BigFishC68/MineKey/docs/01-原理图审查.md

# 11 键 + EC11 旋钮键盘 —— 原理图审查报告

| 项目 | 内容 |
|---|---|
| 审查对象 | `keyboard.eprj2`（嘉立创 EDA 专业版工程）导出的原理图截图 |
| 主控 | CH552G（SOP-16，8051 内核，USB 全速器件） |
| 依据文档 | `CH552DS1.PDF`（WCH CH552/CH551 数据手册，第 4 章引脚、第 8 章时钟、第 16 章 USB、第 18 章参数） |
| 审查方式 | 截图逐区域放大判读 + 手册参数核算 |
| 审查日期 | 2026-10-31 |

> **关于工程文件**：`.eprj2` 是 SQLite 数据库（`SQLite format 3`）。图纸正文加密存放在 `history_data.dataStr` 字段（136 条快照），`schematics` / `documents` / `components` 表均为空，无法直接读出网络表。所以本报告的网络判读全部来自截图，**请对照第 1 节逐一核对**，如有出入告诉我，我按真实网络修正结论。

---

## ★ 改板核对（2026-10-31 17:23 版 `Keyboard_sch.pdf`）

对比上一版截图，逐项核对结果：

| 编号 | 上次的问题 | 本次改动 | 状态 |
|---|---|---|---|
| P1 | 编码器 100 nF + 内部上拉，τ≈7 ms | **C1/C2 改为 10 nF** | ✅ 已解决 |
| P2 | R1 5.1 kΩ 与内部 1.5 kΩ 并联 = 1.16 kΩ | **5.1 kΩ 已删除** | ✅ 已解决 |
| P3 | 灯珠无去耦 | **U2–U12 每颗一颗 100 nF（C7–C17）** | 🟡 部分解决 |
| P4 | SW2 把 D+ 直接拉 3V3 | **换轻触按键 SW3（TSC01A-TDW1EH3.5）：1→DP / 2→GND，3、4（外壳）接 GND** | ✅ 已解决 |
| S4 | 1N4007 太大 | **12 颗全换 1N4148W** | ✅ 已解决 |
| S6 | 灯珠串阻 470 Ω | **改为 220 Ω** | ✅ 已解决 |
| S1 | 网络名与位号撞车 | 未改（仍是 `R1..R3` / `C1..C4`） | 🟡 建议改 |

**P1 复核数据**：10 nF 配内部 71 kΩ → τ = 0.71 ms，升到 VIH 约 0.46 ms。5 圈/秒时每格 8.3 ms，余量 18 倍，够了。（固件的正交解码表本身对触点抖动是自抵消的，不需要额外加消抖电容。）

**P3 说明**：每颗灯珠的 100 nF 已经到位，这解决了"高频开关噪声"。但没有大电容，缺的是"整串同时点亮时的瞬时电流"。你决定不加、靠软件限流 —— 这是可接受的取舍，**前提是固件必须把总电流压在 300 mA 以内**（已实现，见 `docs/02` 第 6 节）。只要不手动把亮度拉到 90% 以上，USB 端口不会掉电。

---

## 🔴 P4（新发现，必须改）：SW2 把 D+ 直接接到 3V3，USB 永远枚举不了

**现象**（`Keyboard_sch.pdf` 中 SW2 附近）：

```
SW2 (MSK12C02)
  脚1 ── 3V3        ← 直接连线，没有电阻
  脚2 ── DP         ← 公共端（中间脚）
  脚3 ── GND
  脚4 ── GND        （外壳）
```

MSK12C02 是单刀双掷（SPDT），**中间脚是公共端**，所以 D+ 只会落在两种状态：

| 拨到 | D+ 状态 | 结果 |
|---|---|---|
| 1 脚一侧 | 被**硬拉到 3.3 V** | 主机看到"有设备插入"，但 SE0 复位时拉不低 D+ → **枚举失败**（未知 USB 设备） |
| 3 脚一侧 | 被**硬拉到 GND** | 主机看到设备断线 → 不枚举 |

**两种位置都不能正常工作。** 上一版有 5.1 kΩ 时至少还只是个"阻抗不达标"，现在删掉电阻后变成了"低阻硬拉"，反而更严重：D+ 是 USB 的差分信号线，任何时刻都必须能自由摆动。

**改法（一处连线即可）**：

> **把 SW2 的 1 脚从 3V3 断开，改为悬空（NC）。**

改完后：

- 一档：D+ 悬空 → 正常枚举（靠 CH552 内部 1.5 kΩ 上拉，`bUC_DEV_PU_EN=1`）
- 另一档：D+ 短接 GND → 主机认为"拔掉了"，松手重新枚举

这样它就变成一个干净利落的"USB 重新枚举 / 禁用"开关 —— 在板上没有复位键的情况下，这是最实用的应急手段。

> 如果你更想要"两档都有意义"，另一种做法是 1 脚经 **1.5 kΩ** 接 3V3，同时固件改成外部上拉模式（`bUC_SYS_CTRL1/0 = 01`）。但没必要，内部上拉已经够用，而且省一个电阻。

### 澄清：D+ 接地 ≠ 进入烧录模式

翻遍 CH552 手册，**没有任何"上电时把 D+ 拉低就进 ISP"的机制**。ISP 入口只和三件事有关：

| 条件 | 手册依据 |
|---|---|
| 配置位 `No_Boot_Load`（3FF8h bit14） | 表 6.2：1 = 从 3800h 引导程序启动，0 = 从 0000h 应用程序启动 |
| 复位类型 | 7.3.3：**电源上电复位**置 `bBOOT_LOAD=1`，先跑引导程序；引导程序再**软件复位**（`bBOOT_LOAD` 清零）切到应用 |
| DataFlash / 应用主动跳转 | 6.6：预置了 BootLoader 才支持 USB/串口 ISP |

所以拨到 GND 的实际效果是：主机看不到 1.5 kΩ 上拉（全速设备就是靠 **D+ 高电平** 表示"已连接"），判定为**设备拔出**；松开后重新上拉，重新枚举。**它是"USB 重插"键，不是下载键。**

一张表看清三种手段的区别：

| 手段 | 芯片复位 | 上电复位 | 跑 BootLoader | 能下载 |
|---|---|---|---|---|
| 拔插 USB / 断一次 VBUS | ✅ | ✅ | ✅ | ✅ |
| D+ 短一下 GND 再松开 | ❌ 芯片毫无察觉 | ❌ | ❌ | ❌ |
| 按 RST（RST→VCC） | ✅ 热复位 | ❌ | ❌ | ❌ |

依据：手册 7.3.1「**只有上电复位**才使 CH552 重新加载配置信息…其它热复位不影响」；
`bBOOT_LOAD` 只在**电源上电**时置 1。D+ 接地是纯 USB 层动作，连热复位都算不上——CPU 一直在跑你的程序。

### 那这个开关到底留不留？

**D+ 悬空不会损失任何功能**：内部 1.5 kΩ 上拉由 `bUC_DEV_PU_EN` 软件控制，外部什么都不接就是标准接法。这个开关唯一的独占价值是「**不重启固件的前提下让主机重新枚举**」，其余场景都有更好的替代：

| 需求 | D+ 键 | RST 键 | 电源开关 / 拔线 |
|---|---|---|---|
| 主机重新枚举 | ✅ | ✅ | ✅ |
| 救跑飞 / 死循环的固件 | ❌ | ✅ | ✅ |
| 进 BootLoader 烧录 | ❌ | ❌ | ✅ |
| 保留运行状态（不重跑固件） | ✅ | ❌ | ❌ |

关键在于：**热复位同样会产生一次"掉线→重连"**——复位后 `USB_CTRL` 回到 0，内部上拉自动关断，D+ 被主机的 15 kΩ 下拉拉到 0（SE0），主机判定拔出；固件重新 `usb_init()` 再打开上拉，重新枚举。所以 RST 键在"重新枚举"这件事上和 D+ 键等价，还多一个救死循环的能力。

**结论与取舍**：

- 只留一个 → **留 RST**（接 RST→VCC），但必须把 `En_RST_RESET` 置 1，否则按键无效
- 不想动配置位 → 保留 D+ 键，它是**零配置**的替代方案，成本也只有一个按键
- 两个都不留 → 也能正常用，只是以后每次都要拔 USB 线
- **绝对不要**再让 1 脚碰 3V3（那就是 P4 描述的致命接法）

---

## ✅ SW3 接线已确认正确（原 P5 判断有误，已撤销）

`TSC01A-TDW1EH3.5` 的 **3、4 脚是外壳/固定脚**，不是第二个电极。所以当前接法是对的：

| 脚 | 接到 | 说明 |
|---|---|---|
| 1 | DP（P3.6） | 开关的一个触点 |
| 2 | GND | 另一个触点 |
| 3、4 | GND | **金属外壳**接地，标准做法（抗 ESD / EMI，顺带固定外壳电位） |

按下 → D+ 短地 → 主机判定拔出；松开 → 内部 1.5 kΩ 恢复 → 主机判定插入 → 重新枚举。**不需要改。**

> 我上一版按"四脚 = 两个电极 + 两个复制脚"推断，属于误判——符号里两个触点只画在 1、2 上，本身已经说明 3、4 是机械脚，是我没读仔细。以后遇到拿不准的开关符号，用万用表蜂鸣档量一次最稳：不按时 1–2 应断开、3–4 应与 1/2 隔离。

**两个小建议**（都不影响功能）：

1. 顶部那个 GND 符号是上下翻转的（横线朝上），电气无影响，但视觉上像天线，建议转正。
2. 外壳接地后，按键金属壳与 GND 同电位，手指接触时不会引入干扰——这也是为什么很多键盘的开关外壳都接地。

**回到烧录**：WCHISPTool 里点"下载"→ **冷启动**（拔插 USB 线或断一次电源）。软件复位会清 `bBOOT_LOAD`，所以**按 RST 键也进不了 bootloader**（这就是 CH552 圈子里"必须拔插 USB"的由来）；SW3 只负责重枚举，同样不能用于下载。

### 两个实务建议

1. **把 SW2 从拨动开关换成 6×6 轻触按键**（D+ → GND，按下才短接）。拨动开关有个坑：停在 GND 档上电 = 板子从系统里"消失"，很容易被误判成板子坏了。丝印写 **`USB`**，别写 `BOOT`。
2. **RST 是高电平复位**（引脚表注明"RST 引脚内置下拉电阻"），要加复位键必须接 **RST → VCC**，不能接 GND。而且表 6.2 的 `En_RST_RESET` 建议值是 0（默认不使能手工复位输入），要用得在下载工具里改配置——所以本版建议 RST 保持悬空，下载靠拔插线。

---

## 0. 一句话结论

**电路拓扑是对的，可以打样。但有 3 个会真实影响使用的问题必须先改**：编码器 RC 时间常数过大（高速旋转会丢步）、USB 的 D+ 上拉电阻阻值错误（和芯片内部 1.5 kΩ 并联后超出 USB 规范）、灯珠没有储能电容（11 颗 WS2812 满亮 660 mA 而板上只有 200 nF）。

---

## 1. 我读到的电路（请核对）

### 1.1 CH552G 引脚分配

| 脚 | 引脚名（手册） | 网络 | 用途 | 备注 |
|---|---|---|---|---|
| 1 | P3.2/TXD1_/INT0/VBUS1/AIN3 | SA | 编码器 A 相 | 可作 INT0 中断 |
| 2 | P1.4/T2_/CAP1_/SCS/TIN2/UCC1/AIN1 | R2 | 矩阵行 2 | 也是 ISP 的 SCS |
| 3 | P1.5/MOSI/PWM1/TIN3/UCC2/AIN2 | R3 | 矩阵行 3 | |
| 4 | P1.6/MISO/RXD1/TIN4 | C3 | 矩阵列 3 | |
| 5 | P1.7/SCK/TXD1/TIN5 | C4 | 矩阵列 4 | |
| 6 | RST/T2EX_/CAP2_ | —（打叉悬空） | 复位 | 内部有下拉 |
| 7 | P3.1/PWM2_/TXD | C1 | 矩阵列 1 | |
| 8 | P3.0/PWM1_/RXD | R1 | 矩阵行 1 | |
| 9 | P1.1/T2EX/CAP2/TIN1/VBUS2/AIN0 | C2 | 矩阵列 2 | |
| 10 | P3.3/INT1 | RGB | WS2812 数据 | 软件模拟时序 |
| 11 | P3.4/PWM2/RXD1_/T0 | SB | 编码器 B 相 | |
| 12 | P3.6/UDP | DP | USB D+ | 只能到 V33 电平 |
| 13 | P3.7/UDM | DM | USB D− | 只能到 V33 电平 |
| 14 | GND/VSS | GND | 地 | |
| 15 | VCC/VDD | VCC | 5 V（USB VBUS 直供） | |
| 16 | V33 | 3V3 | 内部 3.3 V LDO 输出 | 挂 C4 100 nF |

**特点：16 个脚用满 15 个，除 RST 外没有一根空余 GPIO。** 好处是没有浪费；代价是没有调试串口、没有状态灯、没有 VBUS 检测脚（第 5 节会用到这个结论）。

### 1.2 按键矩阵（3 行 × 4 列，12 个位置全用）

| 位置 | 轴座 | 二极管 | 行 | 列 |
|---|---|---|---|---|
| 1 | CN1 | D1 | R1 | C1 |
| 2 | CN2 | D2 | R1 | C2 |
| 3 | CN3 | D3 | R1 | C3 |
| 4 | **编码器按压** | D4 | R1 | C4 |
| 5 | CN4 | D5 | R2 | C1 |
| 6 | CN5 | D6 | R2 | C2 |
| 7 | CN6 | D7 | R2 | C3 |
| 8 | CN7 | D8 | R2 | C4 |
| 9 | CN8 | D9 | R3 | C1 |
| 10 | CN9 | D10 | R3 | C2 |
| 11 | CN10 | D11 | R3 | C3 |
| 12 | CN11 | D12 | R3 | C4 |

- 轴座 2 脚：一脚进行线（R1/R2/R3），另一脚**经二极管阳极**到列线。
- **12 颗二极管的阴极全部朝向列线**（D1/D2/D3 阴极朝下，D5/D8 等符号镜像后阴极朝上，电气方向一致）。
- 所以扫描方向是**唯一**的：**列线输出低电平，行线作输入并靠内部上拉读高**。按键按下时电流走 `行上拉 → 轴 → 二极管 → 列(低)`，行读到 0。反过来（行输出高、列读）二极管截止，永远读不到。

> 这一点直接决定固件写法，别写反（写反的表现是「一个键都测不到」，很容易误判成硬件坏）。

### 1.3 EC11 编码器（SW1 = EC11E15244G1）

| 脚 | 连接 |
|---|---|
| A | 网络 SA → P3.2，并挂 C2 100 nF 到 GND |
| B | 网络 SB → P3.4，并挂 C1 100 nF 到 GND |
| C | GND（公共端接地，A/B 靠内部上拉拉高，低电平有效） |
| 6 / 7 | 外壳固定脚 → GND（正确） |
| D | → D4 阳极 → 列 C4 |
| E | → 行 R1 |

按压开关走矩阵（R1×C4），不占额外 GPIO —— 这个做法是对的，省了一根线。

### 1.4 USB

- 接口：Type-C 16 pin（`MC-311S`），USB 2.0 only。
- `CC1`、`CC2` 各经 R3/R4 **5.1 kΩ 下拉到 GND** → UFP（从设备）正确，能让 C-to-C 线正常取电。
- `DN1+DN2` 并成 DM、`DP1+DP2` 并成 DP；`SBU1/SBU2` 打叉悬空 —— 都正确。
- 4 个 `SHELL` 直接接地。
- **D+ 上有一颗 R1 5.1 kΩ 到 V33（3.3 V），中间串一个拨动开关 SW2 = MSK12C02**（1 脚经 R1 到 3V3，2 脚 DP，3 脚 GND）。
- 无 ESD 器件、无 D+/D− 串阻、无自恢复保险丝。

### 1.5 WS2812 灯链（11 颗，U2–U12）

- `VDD` 接 VCC（5 V），`VSS` 接地，4 pin 封装（1=VDD, 2=DOUT, 3=VSS, 4=DIN）。
- 数据：**P3.3 → R2 470 Ω → U5 DIN**。
- 串联顺序（**注意方向是从右往左**）：

```
R2 → U5 → U4 → U3 → U2 →(跨行)→ U9 → U8 → U7 → U6 →(跨行)→ U12 → U11 → U10 (DOUT 悬空)
索引    0     1     2     3          4     5     6     7           8      9      10
```

如果灯珠是按轴位排的，那 `LED[0]` 对应的是**第 1 行最右**那颗，不是 CN1 —— 配置软件里我做了「灯珠顺序表」，可以随时改。

---

## 2. 必须修改（改动前不要投板）

### P1 🔴 编码器 RC 时间常数大了约 7 倍，快速旋转必丢步

**现象**：A/B 各挂 100 nF 到地，靠 CH552 内部上拉拉高。

**核算**（手册 18.2 电气参数，VCC=5 V）：

- 内部上拉电流 `IUP5` = 35 / **70** / 140 µA（min/typ/max）→ 等效上拉电阻 ≈ 5 V / 70 µA ≈ **71 kΩ**。
- τ = R × C = 71 kΩ × 100 nF = **7.1 ms**。
- 上升到 VIH（2.4 V）需要 7.1 ms × ln(5/2.6) ≈ **4.6 ms**。

**这意味着什么**：EC11 是 24 定位/24 脉冲，1 圈 24 步。

| 转速 | 每步时间 | 4.6 ms 上升沿占比 | 结果 |
|---|---|---|---|
| 1 圈/秒 | 41.7 ms | 11% | 正常 |
| 3 圈/秒 | 13.9 ms | 33% | 开始丢步/跳步 |
| 5 圈/秒 | 8.3 ms | 55% | 基本不可用 |

也就是说：**慢慢转没事，手感一快就丢**。这是最容易在打样后才被发现、又最难查的一类问题。

**修改方案（任选一，推荐 A）**：

- **A（推荐）**：A/B 各加 **10 kΩ 外部上拉到 VCC**，100 nF 保留。τ = 1 ms，到 VIH 0.65 ms，5 圈/秒也稳。
- **B**：不加电阻，把 C1/C2 从 100 nF 改成 **4.7 nF**。τ = 0.33 ms，也能用，但抗干扰变差。
- **C**：加 10 kΩ 上拉 + 电容降到 **10 nF**（τ = 0.1 ms），最干净的组合，也最省心。

**附带一个细节**：100 nF 并在机械触点上，每次接触放电能量 ½CV² = 1.25 µJ。EC11 的触点是镀金的，长期每天几千次旋转，建议控制在 1 µJ 以内 —— 这也是把电容降到 10–22 nF 的另一个理由。

---

### P2 🔴 R1 = 5.1 kΩ 与芯片内部 1.5 kΩ 上拉并联，D+ 阻抗出规范

**手册依据**：CH552 的 USB 上拉由 `USB_CTRL` 的 `bUC_SYS_CTRL1/0` 控制（手册 16.2）：

| SYS_CTRL1 | SYS_CTRL0 | 含义 |
|---|---|---|
| 0 | 0 | 关 USB，关内部上拉 |
| 0 | 1 | 开 USB，**关内部上拉，需外接上拉** |
| 1 | X | 开 USB，**启用内部 1.5 kΩ 上拉** |

USB 全速设备要求 D+ 上拉 1.5 kΩ ±5%（1.425–1.575 kΩ）。你现在的电路：

```
内部 1.5 kΩ ∥ 外部 5.1 kΩ = 1.16 kΩ   ← 低于下限 1.425 kΩ
```

严格的 Host/Hub（部分 Mac、带 Hub 的显示器、Linux 的某些 UDC 检查）会拒绝枚举，表现是「设备描述符请求失败 / 未知 USB 设备」；宽容的 Host 能认出来，于是这个 bug 会**只在别人的电脑上出现**，最难复现。

**修改方案（任选一）**：

- **A（推荐，最省事）**：**删掉 R1**，SW2 只保留「DP ↔ GND」两态，做成「USB 重新枚举」按钮（D+ 拉低 = Host 看到断线，松手重新枚举）。固件用内部 1.5 kΩ（`SYS_CTRL1=1`）。这是 CH552 没有复位键时最实用的应急手段。
- **B**：把 **R1 改成 1.5 kΩ**，固件用「外部上拉」模式（`SYS_CTRL=01`）。这样 SW2 变成一个真正的「USB 使能开关」，插上不识别时拨一下就能强制 Host 重新枚举。注意此时**不能再开内部上拉**，否则又是并联。
- **C**：R1 改 1.5 kΩ 且固件仍用内部上拉 —— 不行，理由同上。

> 顺带：R1 挂在 **V33**（内部 LDO 输出）上，手册 5V 档明确写「V33 仅外接电容」，作为 0.4 mA 的上拉电源虽然能工作，但不是它的设计用途，而且 `bLDO3V3_OFF` 置位时 V33 会关掉。按方案 A 删掉 R1 可以一并解决。

---

### P3 🔴 灯珠没有储能电容，11 颗 WS2812 会打崩 VBUS

**核算**：

- WS2812B（5050）单颗全白 ≈ 50–60 mA → 11 颗 ≈ **660 mA**；即使按 20 mA/颗的平均亮度算也有 220 mA。
- 板上给 VCC 的电容只有 **C3 + C6 = 200 nF**，另有 C5 100 nF 在主控旁。
- USB 2.0 端口额定 500 mA（未配置前只有 100 mA）。

**后果**：全白一瞬间 VBUS 被拉到 4.0 V 以下 → 灯珠颜色跳变/闪、CH552 掉电复位、Host 报「USB 设备电涌」。这是 RGB 键盘最常见的翻车点。

**修改方案**：

1. 在**第一颗灯珠旁边**加 **≥100 µF（建议 220 µF/6.3 V，低 ESR 固态或钽电容）**，再并 100 nF。这是硬件必做项。
2. 每颗 WS2812 的 VDD–GND 之间加 **100 nF**（WS2812B 手册的要求；空间紧张时至少每 3 颗一颗）。
3. **固件必须做电流预算限制**：把「总亮度上限」压到 500 mA 以内（我已按这个约束写进固件，默认全白亮度只有 40%，并提供「电流上限」参数）。
4. 如果一定要全白满亮，就得改供电（外部 5 V/USB-PD 取电），Type-C 这边要改 CC 配置 —— 属于改方案，不建议这一版做。

---

## 3. 建议修改（不影响能不能用，影响好不好用/好不好修）

### S1 🟡 网络名和位号撞车，建议改名

现在同时存在：电容 **C1/C2/C3/C4/C5/C6**，和矩阵列网络 **C1/C2/C3/C4**；电阻 **R1**，和矩阵行网络 **R1/R2/R3**。

EDA 里网络名和位号是两个命名空间，电气上不冲突，但：

- 看网表/飞线时极易看错（`C1` 到底是那颗 100 nF 还是第 1 列？）；
- 嘉立创的 BOM/贴片环节、以及以后写脚本解析网表时容易出问题；
- 我这次审查就差点被绕进去。

**建议改名为**：列 `COL1–COL4`、行 `ROW1–ROW3`、编码器 `ENC_A/ENC_B`、灯珠数据 `LED_DIN`。改完重编一次编号，成本几分钟。

### S2 🟡 RST（6 脚）悬空 —— 可用，但建议加下拉

手册 4 章明确「RST 引脚内置下拉电阻」，且 CH552 是**高电平复位**，所以悬空在电气上是允许的。

但是：板上**没有任何复位手段**。调试期间想复位只能拔线；`RST` 又是唯一一根还能自由支配的脚。

**建议**：RST 加 **10 kΩ 下拉到 GND**，并在旁边留一个 **按键位（RST–VCC）** 或至少一个测试点。花两个元件，换来的是以后每次调试省 10 秒。若担心误触发，可再并 100 nF 到地做滤波。

### S3 🟡 行线只有 70 µA 内部上拉，建议加外部上拉

矩阵扫描靠 `IUP5` 的 70 µA 上拉（≈71 kΩ）把行线拉高。这个阻抗偏高，而板子上 800 kHz 的灯珠数据线就在旁边。

**表现**：可能出现「没按也报按下」（鬼键）或按一下触发多次，尤其在灯珠全亮、电流大的时候。

**建议**：行线上加 **10 kΩ 上拉到 VCC**（3 颗电阻），把行线阻抗降到 10 kΩ 以下，噪声余量立刻改善。列线是推挽输出低，不需要。

### S4 🟡 1N4007 用在这里偏大

电气上没问题（矩阵里只有几十 µA，正向压降约 0.35 V，远低于 VIL=1.2 V）。但：

- DO-41 直插封装在键盘板上非常占地方；SMA 封装也有 4.3 × 2.6 mm；
- 结电容约 15 pF，比 1N4148 大一个量级（对 3×4 的矩阵没什么影响，但没必要）。

**建议**：换 **1N4148W（SOD-123）** 或 **BAS16/BAT54**。如果已经按 1N4007 画好封装，也可以不改 —— 不是阻塞项。

### S5 🟡 USB 没有任何 ESD 保护

D+/D− 直接进芯片，插拔时的静电会直接打在 P3.6/P3.7 上。CH552 的 IO 有对 VCC/GND 的钳位二极管，能扛一部分，但键盘是天天插拔的东西。

**建议**：加一颗 **USBLC6-2SC6**（SOT-23-6，6 分钱级别）跨在 D+/D− 与 VBUS/GND 之间。空间不够的话，至少留 0402 位置不贴。

### S6 🟢 灯珠数据串阻 470 Ω 偏大但可用

WS2812B 推荐 33–500 Ω，470 Ω 在范围内。走线短的话没问题；如果第一颗灯珠离主控超过 5 cm，建议降到 100 Ω。

### S7 🟢 没有空余 GPIO = 没有调试口

15 个脚全用满。好处是没浪费；代价是**没有 UART 调试口、没有状态指示灯、没法做 VBUS 检测**。

**因此固件必须把调试通道做在 USB 上**：我在自定义 HID 报文里留了「原始矩阵状态 + 扫描耗时 + 复位原因」的查询命令，插上就能在配置器里看到实时按键矩阵和扫描周期，不需要串口。这一点已经实现。

> 顺便：`P1.4/P1.6/P1.7` 同时是 ISP 的 SCS/MISO/SCK，被矩阵占用。这不影响 USB 下载（USB ISP 只用 D+/D−），但**板子上没有留 4 线烧写口**，芯片一旦把 USB 配置写坏就救不回来。建议在板边留 4 个测试点（VCC/GND/D+/D−）或者干脆留 RST 测试点 —— 这就是 S2 的另一个理由。

### S8 🟢 CH552 是「不推荐新设计」的老型号

手册第 3 章原话：

> 注：新设计推荐选用 **CH543** 和 **CH548** 芯片；新设计不建议选 CH552E。

CH552G 现在仍然好买、便宜（约 ¥2），生态成熟（SDCC 工具链 + WCHISP 下载），做这一版完全没问题。但如果这个键盘以后要小批量卖，建议下一代评估 CH548（同封装 SOP16 的型号需要核对引脚定义）。**这一版不用改。**

---

## 4. 做得对的地方（别改）

1. **VCC 直接用 USB 5 V，V33 只挂 100 nF** —— 完全符合手册 18.2「VCC 3.7–5.5 V，V33 仅外接电容」。很多人在这里把 V33 短接到 VCC 或反过来，都是错的。
2. **灯珠和主控同为 5 V** —— 逻辑电平天然匹配。CH552 在 5 V 下 VOH = VCC−0.4 = 4.6 V，WS2812B 的 VIH = 0.7×VDD = 3.5 V，余量 1.1 V，很健康。（如果当初用 3.3 V 供电，这里就必须加电平转换。）
3. **Type-C 的 CC1/CC2 各 5.1 kΩ 下拉** —— UFP 标准做法，C-to-C 线也能正常供电。
4. **DN1/DN2、DP1/DP2 并联，SBU 悬空** —— USB 2.0 only 的正确接法。
5. **矩阵二极管方向一致（全部阴极朝列）** —— 没有鬼键，方向统一，固件好写。
6. **编码器 C 脚接地、6/7 外壳脚接地** —— 正确。外壳接地能显著降低旋转时的干扰。
7. **编码器按压开关并入矩阵** —— 12 个输入只用了 7 根线，很省。
8. **灯珠链首端 470 Ω 串阻** —— 有的，位置也对（在主控侧，不是灯珠侧）。
9. **每颗轴座都有独立二极管** —— 全键无冲（NKRO 可做到 12 键同时）。

---

## 5. 需要你提供 / 确认的资料

按重要性排序，前 3 项会直接影响我下一步的代码和结论：

| # | 需要什么 | 为什么 | 怎么给我 |
|---|---|---|---|
| 1 | **原理图 PDF 或网表** | 我只能靠截图判读，第 1 节的表格需要你逐行确认；有网表我就能做电气规则检查（悬空、单点网络、短路） | 嘉立创 EDA 专业版：`文件 → 导出 → PDF`；或 `设计 → 导出网表` |
| 2 | **PCB 布局图 / 3D 预览** | 配置器要画真实的键位排布（现在按「4×3 网格 + 旋钮在右上」假设）；灯珠物理顺序也要和键位对应 | PCB 页面截图，或 `文件 → 导出 → 3D 预览/图片` |
| 3 | **EC11E15244G1 实际规格** | 定位数/脉冲数决定去抖参数和加速曲线（我按 24/24 算的） | 看实物丝印或购买页参数 |
| 4 | WS2812 具体型号 | 5050 / 2020 / 反贴，决定单颗电流和亮度上限 | 采购链接或丝印 |
| 5 | 键位功能规划 | 11 个键分别想干什么（数字小键盘？快捷键？层切换？） | 一句话描述即可 |
| 6 | 是否需要多媒体键 / 鼠标 | 决定 HID 描述符要不要带 Consumer/Mouse 集合（我已默认带上） | 是/否 |
| 7 | VID / PID | 没有 USB-IF VID 的话用 **pid.codes 的 0x1209**；PID 自己挑一个不冲突的（我暂用 `0x1209:0x0001`） | 确认或指定 |

---

## 6. 上电前检查清单

打样回来第一次上电，按这个顺序走，能省掉 80% 的返工：

- [ ] **先不插灯珠链以外的负载**，用万用表量 VCC–GND 是否短路（应为 >1 kΩ）
- [ ] 插 USB，量 VCC = 5.0 V、V33 = 3.3 V（3.14–3.4 V 都算正常）
- [ ] 量 R1/R2/R3 三个行线：未按键时应为高（≈5 V）；按住任一键，对应行应变成 ≈0.3 V
- [ ] 量 SA/SB：静止时都是高；慢转旋钮，两路应交替出现低电平
- [ ] 用 WCHISP 工具能否识别到芯片（如果能，说明 D+/D− 和供电都 OK）
- [ ] 下载固件后，设备管理器出现「HID 键盘设备」，且**没有黄色感叹号**
- [ ] 打开配置器，能看到设备信息 + 实时按键矩阵
- [ ] 灯珠：先只点 1 颗（亮度 10%），确认颜色正确再全亮

---

## 7. GPIO 预算与固件可行性结论

| 资源 | 用量 | 余量 |
|---|---|---|
| GPIO | 15 / 15（RST 除外） | **0** |
| Flash | 16 KB（用户区 14 KB + Bootloader 2 KB） | 估算固件 ~9–11 KB，够 |
| iRAM | 256 B | 紧张，需静态分配 |
| xRAM | 1 KB | USB 缓冲 128 B + 灯珠帧缓冲 33 B + 配置 64 B，够 |
| 定时器 | Timer0（1 ms 节拍）+ USB SOF | 够 |

**结论：这个方案软件上完全可行**，唯一的硬约束是「没有空余 GPIO」，所以所有调试、配置、灯效参数都必须走 USB HID 报文 —— 这也是我下面写的软件的设计前提。

灯珠驱动只能用**软件模拟时序**（P3.3 不是 SPI 引脚，而 P1.5/P1.6/P1.7 被矩阵占了，用不了硬件 SPI）。24 MHz 主频下 1 个时钟 41.7 ns，WS2812B 要求 T0H=0.4 µs、T1H=0.8 µs，用汇编 + 关中断可以做到，但**必须用逻辑分析仪标定一次**（固件里留了标定用的宏）。

---

## 附：修改清单速查（给改板用）

| 编号 | 位置 | 现在 | 改成 | 优先级 |
|---|---|---|---|---|
| P1 | 编码器 A/B | 100 nF + 内部上拉 | **加 10 kΩ 上拉到 VCC**（或电容改 10 nF） | 🔴 必改 |
| P2 | R1 | 5.1 kΩ 到 V33 | **删除 R1**（SW2 只做 D+→GND）或改 1.5 kΩ | 🔴 必改 |
| P3 | 灯珠供电 | 200 nF | **+220 µF 低 ESR + 每颗 100 nF** | 🔴 必改 |
| S1 | 网络名 | C1..C4 / R1..R3 | COL1..4 / ROW1..3 | 🟡 建议 |
| S2 | RST | 悬空 | 10 kΩ 下拉 + 按键/测试点 | 🟡 建议 |
| S3 | 行线 | 仅内部上拉 | +10 kΩ 上拉 ×3 | 🟡 建议 |
| S4 | 二极管 | 1N4007 | 1N4148W (SOD-123) | 🟡 建议 |
| S5 | USB | 无保护 | USBLC6-2SC6 | 🟡 建议 |
| S6 | 灯珠串阻 | 470 Ω | 走线长则降 100 Ω | 🟢 可选 |
