BigFishC68/MineKey/docs/02-软件架构与协议.md

# 软件架构与协议说明

> 版本：v1.0（2026-11-11 已完成真机烧录：USB 枚举 + 四集合 + 配置通道 INFO 往返通过，见 `docs/04` 第十节；按键矩阵与键位存储仍待人工验证）

---

## 1. 整体结构

```
┌─────────────────────────────┐        HID (WebUSB 不需要)
│  tools/configurator         │  ◄──────────────────────────┐
│  Chrome / Edge 打开的网页    │    Feature 0x10 / Report 1-4│
└─────────────────────────────┘                             │
                                                            │
┌─────────────────────────────┐                             │
│  CH552 固件                 │─────────────────────────────┘
│                             │
│  main()  ──► 1ms 节拍        │
│    ├─ matrix_scan()          │  4 列 × 3 行 + 12 二极管
│    ├─ encoder_poll()         │  A/B 正交解码
│    ├─ keys_update()          │  消抖 + 功能码映射
│    ├─ build_reports()        │  → EP1 IN (ID1/2/4)
│    └─ led_effect()/flush()   │  → P3.3 位翻转
│                             │
│  USB ISR                     │
│    ├─ EP0 控制传输           │  描述符 / Feature 读写
│    └─ EP1 IN 完成            │  释放忙标志
└─────────────────────────────┘
```

**没有空余 GPIO**，所以所有调试能力都做在 USB 上：设备信息、实时矩阵、扫描周期、按键计数，全部通过 Feature/Status 报文读取，不需要串口。

---

## 2. 文件清单

```
firmware/
  Makefile                SDCC 构建脚本
  src/
    ch552.h               寄存器定义（地址取自手册 SFR 表）
    board.h               引脚映射、矩阵尺寸、配置结构
    usb.c                 描述符 + EP0/EP1 + 事件轮询（usb_poll）
    app.c                 扫描 / 编码器 / 报文 / 灯效 / 配置 / 协议
    usb.h, app.h          接口
  test/
    host_stub.h           把 SFR 伪造成普通变量
    host_main.c           主机端语法检查入口

tools/configurator/
  index.html              界面结构
  styles.css              样式（深色，纯色背景）
  app.js                  设备层 + 界面逻辑 + 演示模式

tools/configurator-win/
  MineKey.csproj          WinForms + WebView2 宿主；www 直接从 ../configurator 链接
  Program.cs              窗口、WebView2 初始化、消息桥
  HidBridge.cs            Windows 原生 HID（SetupAPI + HidD_*）
  app.manifest            PerMonitorV2 DPI、Win10/11 兼容声明
  assets/icon.ico         应用图标
  run.bat                 一键构建并启动
  build-release.bat       发布单文件 exe（自带运行时）
```

`firmware/` 可以用 gcc 做一次语法/类型检查（不需要 SDCC）：

```bash
cd firmware
gcc -std=c99 -DHOST_CHECK -Itest -Isrc test/host_main.c src/app.c src/usb.c -o /tmp/check
```

---

## 3. USB 描述符

| 项 | 值 | 说明 |
|---|---|---|
| VID / PID | `0x1209` / `0x0001` | 未注册 USB-IF 时的通用做法；**出厂前请改成自己的** |
| bcdUSB | 2.00 | 全速 12 Mbps |
| bMaxPacketSize0 | **64** | 关键：ID + 63 字节 Feature Report = 64，一个包传完 |
| 配置 | 1 个接口，HID，EP1 IN 中断 | 16 字节 / 1 ms |
| 接口子类 | 0 / 0 | 不做 Boot 协议（BIOS 里用不了，见第 9 节） |

### 为什么 USB 事件是轮询而不是中断

CH552 的 USB 中断号是 **8**，向量地址 `0x0043`。但 SDCC 的 mcs51 后端只为
中断号 `0~5`（`0x03`/`0x0B`/`0x13`/`0x1B`/`0x23`/`0x2B`）生成跳转向量，
`__interrupt(8)` 会被**静默丢弃**：既不报错，也不生成 `ljmp`。后果是
USB 事件永远进不来；更糟的是若还置位 `IE_EX_USB`，CPU 会跳到 `0x0043`
处的普通代码上执行而跑飞。

所以 `usb.c` 里的事件处理函数叫 `usb_poll()`，由主循环高频调用：

```c
for (;;) {
    usb_poll();          /* 几个微秒一次，远快于 USB 的 1ms 帧 */
    if (tick_flag) { tick_flag = 0; app_tick(); }
}
```

`USB_INT_EN` 仍然照常设置（只用来产生标志位），但 `IE_EX_USB` 保持关闭。
附带好处：`app_feature()` 不再在中断里改 `cfg`，消除了与主循环并发读写
配置结构的竞态；`ep1_busy` 也不再需要关中断保护。

### 报告 ID 一览

| ID | 方向 | 长度 | 内容 |
|---|---|---|---|
| `0x01` | IN | 8 字节 | 键盘：修饰键、保留、6 个键码 |
| `0x02` | IN | 2 字节 | 多媒体：16 位 Consumer Usage |
| `0x03` | IN | 8 字节 | 状态：矩阵位图 + 旋钮计数 + 标志 |
| `0x04` | IN | 4 字节 | 鼠标：按键位 + X + Y + 滚轮 |
| `0x05` | IN | 1 字节 | **主机动作触发**：动作编号 0–63 |
| `0x10` | Feature | 63 字节 | 配置通道（读写都走这个；+报告 ID = 64，EP0 单包） |

### 状态报文（ID 3）字节定义

| 字节 | 含义 |
|---|---|
| 0 | 矩阵 bit0–bit7（bit = row×4 + col） |
| 1 | 矩阵 bit8–bit11（低 4 位） |
| 2 | 旋钮净刻度（有符号，每次状态包后清零） |
| 3 | 标志位：bit0 = FN 层（预留） |
| 4–7 | 保留 |

矩阵位序与键位对应（**与原理图一致**）：

| bit | 0 | 1 | 2 | 3 | 4 | 5 | 6 | 7 | 8 | 9 | 10 | 11 |
|---|---|---|---|---|---|---|---|---|---|---|---|---|
| 位置 | R1C1 | R1C2 | R1C3 | R1C4 | R2C1 | R2C2 | R2C3 | R2C4 | R3C1 | R3C2 | R3C3 | R3C4 |
| 元件 | CN1 | CN2 | CN3 | **编码器** | CN4 | CN5 | CN6 | CN7 | CN8 | CN9 | CN10 | CN11 |
| 界面上 | 下排1 | 下排2 | 下排3 | **右上旋钮** | 下排4 | 中排5 | 中排6 | 中排7 | 中排8 | 上排9 | 上排10 | 上排11 |

> 界面按**物理位置**编号（从左到右、从下到上），矩阵按**走线**分配，两者错开一格：
> 电气 R1C4 是旋钮（界面右上角），R2C1 是 CN4（界面下排最右），R3C1 是 CN8（界面中排最右）。
> 配置器里 `LAYOUT` 表的 `gx/gy` 管界面位置、`row/col` 管电气坐标，互不影响。

---

## 4. 配置协议（Feature 0x10）

### 帧格式

**请求**（主机 → 设备）：63 字节（总线上 reportId + 63 = 64 字节，EP0 单包）
```
[0] = 命令字
[1..62] = 参数
```

**响应**（设备 → 主机）：63 字节（同上）
```
[0] = 命令字 | 0x80      ← 回显，便于主机配对
[1] = 状态码  0=OK 1=未知命令 2=参数错误
[2..62] = 数据
```

### 命令表

| 命令 | 码 | 参数 | 返回 |
|---|---|---|---|
| GET_INFO | `0x01` | — | `[2]`协议版本 `[3][4]`固件版本 `[5][6]`矩阵行列 `[7]`键数 `[8]`灯数 `[10..]`设备名 |
| GET_KEYMAP | `0x02` | — | `[2+2i]` 第 i 个键的功能码（小端） |
| SET_KEY | `0x03` | `[1]`键索引 `[2][3]`功能码 | — |
| SET_ALL_KEYS | `0x04` | `[1..22]` 11 个功能码 | — |
| GET_ENC | `0x05` | — | `[2]`CW `[4]`CCW `[6]`按压 `[8]`极性 |
| SET_ENC | `0x06` | `[1]`CW `[3]`CCW `[5]`按压 `[7]`极性 | — |
| GET_LED | `0x07` | — | `[2]`模式 `[3]`亮度 `[4]`速度 `[5..7]`RGB `[8+3i]`逐键 RGB |
| SET_LED | `0x08` | 同上 | — |
| SAVE | `0x09` | — | 写入 DataFlash（约 3.6 ms，主循环执行） |
| FACTORY_RESET | `0x0A` | — | 恢复默认并保存 |
| BOOTLOADER | `0x0B` | — | 预留（CH552 需冷启动才能进 ISP） |

### 功能码（16 位）

| 高字节 | 含义 | 低字节 |
|---|---|---|
| `0x01` | 键盘按键（HID Page 0x07） | Usage，如 `0x04`=A、`0x29`=Esc、`0xE0`=左 Ctrl |
| `0x02` | 多媒体 | 索引：1 音量+ 2 音量− 3 静音 4 播放/暂停 5 下一曲 6 上一曲 7 亮度+ 8 亮度− 9 主页 10 搜索 11 计算器 12 停止 13 快进 14 快退 |
| `0x03` | 鼠标 | 1 左键 2 右键 3 中键 4 滚轮上 5 滚轮下 |
| `0x04` | 内部动作 | 2 亮度+ 3 亮度− 4 换灯效 5 重载配置 6 恢复出厂 |
| `0x06` | **主机动作** | 动作编号 0–63，由电脑上的 `host-agent` 执行（开网页 / 开软件 / 跑命令） |
| `0x07` | **光标移动** | 1上 2下 3左 4右；按住期间每 20ms 发一包相对位移（3px/次） |
| `0x50`–`0x5F` | **组合键**：高半字节是修饰位掩码（1=Ctrl 2=Shift 4=Alt 8=Win） | 键盘 Usage |

示例：`0x0000` 禁用；`0x0129` Esc；`0x0201` 音量加；`0x530B` Ctrl+Shift+H（0x0B = H）。

---

## 4.5 主机动作（按键开网页 / 开软件）

### 为什么需要额外的程序

**键盘没法自己打开网页。** USB HID 键盘能做的事情只有一件：把键码发给主机，由操作系统解释成按键。
想"按一下开 B 站"，链路必须是：

```
按键 → 固件判定这个键是"主机动作 0" → 发 Report ID 5, 数据 [0]
                                          │
                         电脑上常驻的 agent.py 读到 → 执行 actions.json 里 0 号动作
```

固件只负责发编号，**具体打开什么完全由电脑上的 `actions.json` 决定**，所以改功能不用重烧固件。

### 数据流

| 环节 | 内容 |
|---|---|
| 固件 | 键的功能码 `0x06xx`，xx = 动作编号；按下沿发一次 `[0x05, xx]` 就结束，不重发 |
| 代理 | `hid.read()` 读到 report id 5，取 `data[1]`，查表执行 |
| 配置 | `actions.json` 里 `"0" .. "11"` 各对应一个 `{name, type, target}` |

### 动作类型

| type | 含义 | target 示例 |
|---|---|---|
| `url` | 用默认浏览器打开 | `https://www.bilibili.com` |
| `app` | 启动程序 | `C:/…/Code.exe` |
| `folder` | 打开文件夹 | `D:/work` |
| `cmd` | 执行命令 | 任意命令行（谨慎使用） |

### 配置器里的操作

「动作」标签页编辑 12 个槽位（名称 / 类型 / 目标），点「导出 actions.json」，
把文件放到 `tools/host-agent/` 下，然后 `python agent.py` 常驻。
**绑定在「按键」页做**：功能类型选「主机动作」，具体值选槽位 —— 动作页只负责编辑槽位内容，
不再重复提供"绑定到此键"，避免两条写路径互相打架。

以后想换功能只改 json，不用碰固件。

> 网页类是例外：配置器自己开着的时候，收到动作会直接 `window.open`，可以先不装代理试效果。

---

## 5. 按键处理流程

```
1ms 节拍
  ├─ matrix_scan()      逐列拉低，读 3 行 → 12 位原始位图
  ├─ matrix_debounce()  每 bit 独立计数，连续 3 次一致才更新（3ms 消抖）
  ├─ encoder_poll()     读 A/B → 16 项状态表 → 累计 4 个边沿 = 1 格
  ├─ keys_update()      位图 → active_sw[]，内部动作在按下沿执行一次
  ├─ encoder_dispatch() 旋钮格数 → 生成 2ms 的"按键脉冲"
  └─ build_reports()    汇总所有生效码 → 键盘/多媒体/鼠标三份报文
```

**为什么旋钮用"脉冲"而不是连续按键**：一个节拍内可能转好几格，而 EP1 同一时刻只能挂一包。连续发两包（按下 + 抬起）时第二包会因为 `ep1_busy` 而丢失。改成"让这个码在报文里存在 2 ms"，主机在 1 ms 轮询里必然能看到按下和抬起各一次。

**为什么二极管方向决定了扫描方向**：二极管阴极接列线，所以电流只能从"行 → 轴 → 二极管 → 列"。要检测到按键，必须列输出低、行靠上拉拉高。反过来写（行输出高、列读）永远读不到 —— 这是最容易被误判成"硬件坏"的软件错误。

---

## 6. 灯效与电流

灯效在 20 ms 节拍里重算，`led_buf` 存 GRB 顺序（WS2812 要 G 先发）。

| 模式 | 说明 |
|---|---|
| 0 常亮 | 逐键颜色 × 亮度 |
| 1 呼吸 | 每颗加相位偏移，形成波浪 |
| 2 彩虹 | 色相随时间与索引旋转 |
| 3 按压缩放 | 按下 100%、松开 20% |
| 4 关闭 | 全灭 |
| 5 彩虹呼吸 | 色相旋转 + 全局呼吸 |
| 6 单点扫描 | 亮点沿灯珠顺序跑，后一颗留 1/3 拖尾 |
| 7 星光闪烁 | 慢速伪随机，少数灯珠点亮 / 半亮 |

灯效切换键（内部动作 4）在 0–7 之间循环。新增的 5/6/7 只用 `led_t` 做相位，不占额外 RAM。

**电流限幅**：累加 33 个通道值 `sum`，超过 `LED_SUM_LIMIT`（= **5200**）就整体右移压暗。
估算模型：`11 mA（主控）+ 19 mA × sum/255`，5200 对应 **≈400 mA**。满白 11 颗约 640 mA，必须压。

**双端同阈值**：

| 端 | 行为 |
|---|---|
| 固件 | 每帧算出 `sum`，超限就 `>>n` 等比压暗（兜底，防止主机乱发） |
| 配置器 | 实时估算，超过 400 mA 时进度条变红、「下发光效」按钮禁用并改文案，**发不出去** |

发送时序用汇编实现（C 生成的代码时序不可控）：

```asm
setb 0xB3        ; P3.3 拉高，t=1
mov a,r6 / rlc a / mov r6,a / jc
'0': nop ×1 → clr → nop ×20 → djnz     高约 7 周期，周期 30 周期
'1': nop ×12 → clr → nop ×9  → djnz     高约 18 周期，周期 30 周期
```

24 MHz 下 1 周期 = 41.67 ns，所以 '0' 高 ≈ 292 ns、'1' 高 ≈ 750 ns，位周期 1.25 µs。

> ⚠️ **这组数字是按 E8051（1T）指令周期估的，必须用逻辑分析仪校准一次**。
> 抓 P3.3：'1' 的高电平应在 0.65–0.95 µs，'0' 在 0.25–0.45 µs。
> 偏短就加 `nop`，偏长就减 `nop`。**如果灯珠颜色明显错乱（比如全绿），第一个怀疑对象就是这里。**

---

## 7. 配置存储

- 位置：CH552 内部 DataFlash，128 字节，从偏移 0 开始，地址 = `0xC000 + (off << 1)`（必须偶地址）
- 结构：`keyboard_config_t`，72 字节，末尾 1 字节 XOR 校验
- 加载：上电时逐字节读出；magic / version / 校验任一不符就用默认值
- 保存：`SAVE` 命令只置标志，真正写 Flash 在主循环里做（写入期间 CPU 会暂停，不能放在 USB 中断里）

---

## 8. 构建、烧录与首次上电

### 8.1 构建

```bash
# 安装 SDCC 4.2+（Windows 有官方安装包，装完把 bin 加进 PATH）
cd firmware
build.bat       # Windows：双击即可，不需要 make
# 或 make       # → minekey.ihx / .hex / .bin
```

`build.bat` 不依赖 make，直接调 `sdcc` + `packihx`，最后打印 hex/bin 文件名。

### 8.2 烧录

1. 装 **WCHISPStudio**（WCH 官网）
2. 板上电（USB 插入），工具里选 `CH552`，点"下载"
3. **如果认不到芯片**：拔掉 USB 再插上（CH552 的 ISP 只在**上电复位**时进入，见手册 7.3.3 与 `No_Boot_Load` 配置位），点下载的瞬间插入也行
   - 注意：**按 RST 键基本进不去** —— 软件复位会清 `bBOOT_LOAD`，必须真正断电一次
   - 板上的 `SW2`（D+→GND）只是让主机重新枚举，**不能用来进 ISP**
4. 选 `minekey.hex`（或 `.bin`），烧完自动运行

**怎么判断当前是什么状态**：

| 设备管理器里看到的 | 说明 | 该做什么 |
|---|---|---|
| `USB\VID_4348&PID_55E0`（黄叹号，代码 28） | 芯片在**出厂 BootLoader**，固件没烧或烧失败 | 正常现象，直接用 WCHISPTool 烧 |
| `HID 键盘设备` / `MineKey`，`1209:0001` | 固件跑起来了 | 打开配置器点「连接设备」 |
| 什么都没有 | USB 没通/没上电 | 查 VBUS、D+/D−、CC 电阻 |

> 代码 28 = "未安装驱动程序"，对 BootLoader 来说是**正常的**（它没有 HID 接口，
> Windows 没有对应驱动，只有 WCHISPTool 自带的能认）。配置器会直接把这个状态翻译成人话提示。

> 板上没有留 4 线烧写口，如果 USB 配置写坏导致枚举不了，只能靠 RST 测试点（建议改板时加上，见审查报告 S2）。

### 8.3 首次上电自检（按顺序）

| 步骤 | 期望现象 | 不通过时先查 |
|---|---|---|
| 1 | 设备管理器出现"HID 键盘设备"，无感叹号 | D+/D− 是否接反、R1 阻值（见审查 P2） |
| 2 | 灯珠全亮（呼吸），颜色正确 | WS2812 时序（第 6 节）、灯珠方向 |
| 3 | 打开配置器 → 点"连接设备"能看到设备 | VID/PID 是否与固件一致 |
| 4 | 按任意轴，配置器里对应键位高亮 | 矩阵扫描方向（第 5 节）、二极管方向 |
| 5 | 转旋钮，计数增减方向正确 | A/B 接反 → 用配置器"极性"翻转 |
| 6 | 按旋钮，`R1C4` 位亮起 | 编码器 D/E 脚是否接在 R1/C4 |
| 7 | 改键位 → 保存 → 拔插后仍然生效 | DataFlash 写入（第 7 节） |

---

## 8.5 桌面版宿主与 HID 桥

### 为什么不用 WebHID

实测（WebView2 运行时 **156.0.4314.58**）：

| 检查项 | 结果 |
|---|---|
| `typeof navigator.hid` | `"object"` |
| `navigator.hid.requestDevice` | 是函数 |
| 实际调用 `requestDevice()` | **Promise 永远不 resolve**（等 3 s 仍是 pending） |

原因：Chromium 的 WebHID 选择器是**宿主（embedder）责任**实现的 UI，WebView2 没有实现，
所以桌面版不能走 WebHID。改为在 C# 侧直接用 Windows HID API。

> 浏览器版（Chrome/Edge 独立窗口）仍然走 WebHID，两套通道并存：
> `app.js` 顶部用 `window.chrome.webview` 是否存在来判定，存在就走原生通道。

### 消息协议（WebView 消息，非 USB）

JS → C#：

| cmd | 参数 | 返回 |
|---|---|---|
| `ping` | — | `{ok, pong, version}` |
| `list` | — | `{ok, devices:[{vid,pid,usagePage,usage,name,path,inputLen,featureLen}]}` |
| `open` | `{vid, pid, usagePage}` | `{ok, name, vid, pid, usagePage, inputLen, featureLen}` |
| `feature` | `{reportId, data[63]}` | `{ok, data[64]}` |
| `run` | `{type, target}` | `{ok}` — 试跑动作：ShellExecute 打开 url/app/folder，cmd 走隐藏窗口 |
| `pick` | `{kind:"file"\|"folder"}` | `{ok, path, canceled}` — 弹系统对话框选路径 |
| `save` | `{name, data, filter:"json"\|"h"}` | `{ok, path, canceled}` — 弹「另存为」并写盘 |
| `close` | — | `{ok}` |

C# → JS（事件，无 id）：

| evt | 说明 |
|---|---|
| `report` | `{evt:"report", id:<reportId>, data:[...不含 reportId]}` |
| `gone` | 设备拔出或读线程退出 |

所有请求带自增 `id`，JS 侧用 `Map` 关联 Promise，默认 3 s 超时；
`pick` / `save` / `run` 会弹模态对话框或启动进程，超时放宽到 10 分钟。

### 几个容易踩的点

1. **长度差 1**：Windows 的 `HidD_GetFeature` 返回完整报告（首字节是 reportId），
   所以 `FeatureReportByteLength = 64`，而固件里的负载是 63 字节。JS 侧统一 `if (len===64) subarray(1)`。
   （2026-11-11 起 Feature 负载从 64 缩到 63：63 + reportId = 64 恰好等于 EP0 单包上限，
   SET_REPORT/GET_REPORT 一个包完成，避免跨两包时固件丢最后一字节的边界问题。）
2. **枚举要开每个接口**：`HidD_GetAttributes` 必须先 `CreateFile` 才能拿到 VID/PID；
   键盘/鼠标这类系统独占设备会打开失败，直接跳过即可（实测全机枚举 ~40 ms）。
3. **读线程 → UI 线程**：`ReadAsync` 在线程池里完成，`PostWebMessageAsJson` 必须在 UI 线程，
   所以经过 `form.BeginInvoke`。
4. **多 top-level collection**：本设备有键盘/多媒体/鼠标/厂商四个 collection，Windows 给每个都建了
   独立接口路径。`open` 时按 `usagePage = 0xFF00` 精确命中厂商 collection，否则会打开成键盘那个，
   Feature 报告拿不到。
5. **WebView2 里不要用 `position:fixed` 做整体缩放**：桌面版把整页包进 `#app`，
   用 CSS `zoom` + `#app` 尺寸 = `窗口尺寸 / zoom` 做等比缩放；`zoom` 会缩放内部坐标，
   所以固定定位元素（toast）必须留在 `#app` 外面。
6. **窗口可缩放后的尺寸约定**：`fitApp()` 取 `min(w/980, h/920)` 作为 zoom（夹在 0.45–2.0），
   保证逻辑画布永远 ≥ 980×920；`fitBoard()` 再按 `.board-wrap` 的可用宽高取正方形边长，
   键位不会被拉成长条。换到缩放不同的显示器时，这两个函数会在 resize 时重算，不需要手动处理 DPI。

---

## 9. 已知限制（这本版不打算解决）

1. **不支持 BIOS / Boot 协议**：接口子类填的是 0，报告带 Report ID。要支持 BIOS 得单独做一个不带 Report ID 的引导接口。
2. **6 键无冲**：键盘报文是标准 8 字节 6KRO。要 NKRO 得加一个 32 字节的位图报文（CH552 的 Flash 还有余量，可以后面加）。
3. **旋钮不能"连续触发"**：一格一个脉冲，快速旋转时格数会被合并到 1 ms 内（人感觉不出来）。
4. **没有 FN 层**：配置结构里没有第二套键表。要做双层的话，加 22 字节 + 一个层索引即可。
5. **WS2812 时序未标定**：见第 6 节警告。
6. **USB 只有内部 1.5 kΩ 上拉**：如果按审查报告把 R1 改成 1.5 kΩ，必须同时把 `usb.c` 里的 `bUC_DEV_PU_EN` 改成外部上拉模式（`SYS_CTRL=01`），否则两个上拉并联。
