BigFishC68/MineKey/docs/04-固件校验报告.md

# 固件与烧录记录校验报告

> 目的：让第三方可以独立复核「烧进去的到底是哪个文件」，不依赖我的口头说明。
> 生成时间：2026-11-11
> 复核工具：`tools/verify_hex.py`（纯 Python，无第三方依赖）

---

## 一、结论速览

| 问题 | 结论 |
|---|---|
| 当前 `firmware\minekey.hex` 是否结构合法 | 合法（599 条数据记录，校验和全对，有 EOF） |
| 是否会覆盖 BootLoader | **不会**。最大地址 `0x24DD`，BootLoader 在 `0x3800-0x3FFF` |
| 最近一次**成功**烧录的是这份文件吗 | **不是**。最近一次成功是 `8815B` 的旧版本 |
| 当前这份 `9438B` 是否被成功写入过 | **没有**。每次都在「写配置位 / 擦除」阶段就中止了 |
| 失败原因是否可能是 hex 有问题 | 不是，三条独立证据见第五节 |

---

## 二、当前文件身份（可逐项核对）

目录：`D:\Codes\Keyboard\firmware\`

| 文件 | 大小 | 修改时间 | SHA256 |
|---|---|---|---|
| `minekey.hex` | 26 658 字节（文本） | 2026-11-10 21:41:44 | `209e4aa9bf92b15c392d427360cb769bacb75478f9018aed707733e1323b7c0c` |
| `minekey.bin` | 9 438 字节（二进制） | 2026-11-10 21:41:44 | `39fab127a44557e4ab8566d9ed9dea56b8ec345e0e8b4afc703b3a2d8ac63240` |

自行复核命令（任意机器，需 Python 3）：

```
cd D:\Codes\Keyboard
python tools\verify_hex.py firmware\minekey.hex firmware\minekey.bin
```

---

## 三、结构校验结果

```
数据记录数 : 599
记录类型   : {0: 599, 1: 1}      ← 1 条 EOF（:00000001FF）
结构错误   : 无                    ← 每条记录的字节数、校验和全部正确
字节总数   : 9429
地址范围   : 0x0000 .. 0x24DD
超出 0x37FF 的字节数 : 0
复位入口 0x0000 : 02 00 56        ← LJMP 0x0056
Timer0 0x000B   : 02 02 7D        ← LJMP 0x027D
```

**关键安全项**：文件最高地址 `0x24DD`，远低于 `0x3800`。CH552 的 ROM BootLoader
固化在 `0x3800-0x3FFF`，用户区任何写入都碰不到它。这也是为什么前面那么多次失败、
反复擦写之后，芯片依然能进 BootLoader 的原因。

### 关于 `minekey.bin` 与 `.hex` 的 9 字节差异

`.bin` 比 `.hex` 的数据多 9 个字节，位置是：

```
0x0004-0x000A   （7 字节）
0x000E-0x000F   （2 字节）
```

这是 8051 中**未被使用的中断向量槽**，`.hex` 里不写这些地址，`makebin -p`
用 `0xFF` 填充。除这 9 个字节外，两者**逐字节完全一致（差异 0）**，同源无疑。

---

## 四、历史烧录记录（原始日志，非我转述）

### 4.1 最后一次「成功」的烧录：2026-11-08 21:22（来自 `烧录.log`）

```
Device#0  UID:18-03-6E-BF-00-00-00-00, BTVER:02.50
21:22:53:006>> 待下载BIN文件长度:8766B
21:22:53:099>> 擦除中...
21:22:53:106>> 擦除长度: 9K
21:22:53:452>> 完成
21:22:53:460>> 编程中...
21:22:54:650>> 完成
21:22:54:657>> 校验中...
21:22:54:893>> 完成
21:22:54:971>> 成功!
```

要点：
- 写入的是 **8766 字节**的构建，不是现在的 9438 字节版本
- 擦除、编程、校验全部通过，**没有**「写配置位」这一行 → 那次工具跳过了配置位
- 该芯片 UID 首字节为 **`18`**

### 4.2 另一次成功：2026-11-09 21:16（用户提供的工具截图）

```
待下载BIN文件长度: 8815B
从用户区跳转BOOT,配置位禁止修改!
成功!
```

同样是 8000+ 字节的旧构建，同样跳过了配置位。

### 4.3 当前这块芯片的 UID 不是 `18`

用直连协议读到的：

```
BTVER 02.50   UID 1F-03-6E-BF-00-00-00-00   （首字节 1F）
```

**`18` ≠ `1F`**，所以 4.1 和 4.3 是**两颗不同的芯片**。这与你说的「用坏两颗」吻合。

### 4.4 之后的每一次都失败了

工具日志停在：

```
待下载BIN文件长度:9438B
开始下载... BTVER / UID
（等待约 5 秒）
（失败：写配置位）
```

日志里**没有**「擦除中」、也没有「编程中」——**说明它根本没碰到代码区就被中止了**。

---

## 五、为什么可以排除「hex 文件有问题」

三条独立证据：

**① 失败点在写代码之前**
工具流程是「写配置位 → 擦代码 → 写代码」。日志显示它在第一步就中止，
后面「擦除中 / 编程中」一行都没有。hex 内容根本没被使用。

**② 用自研直连协议复现，现象一致**
绕过 WCHISPTool，直接用 libusb 跟 BootLoader 对话：

| 命令 | 结果 |
|---|---|
| Detect / 读配置 / 读 UID | 正常应答 |
| SetKey（设写密钥） | 正常，芯片回的校验和 `0xCA` 与计算结果完全一致 |
| FlashVerify（比对 flash 内容） | 正常应答 |
| **FlashWrite（写）** | **完全无应答** |
| **FlashErase（擦）** | **无应答，之后连数据包都开始拒绝接收，必须断电才恢复** |

读全通、写全废。hex 只在「写」这一步才会被用到，而「写」在拿到 hex 之前就已经失败了。

**③ hex 本身通过全部格式校验**
599 条记录校验和全对、EOF 存在、地址不越界、与 bin 逐字节一致（见第三节）。

**④ 供电已排除**
实测 VCC = **5.2V**（手册要求烧录时 ≥ 4.5V），V33 = 3.3V，RST = 0V。

---

## 六、第三方如何独立复核

任选其一：

**方法 A：跑本仓库的校验脚本**
```
python tools\verify_hex.py firmware\minekey.hex firmware\minekey.bin
```
应看到「结构错误: 无」「超出用户区: 0」「结论: 通过」。

**方法 B：用通用工具**
```
srec_info firmware\minekey.hex          # 需安装 srecord
# 或
srec_cat firmware\minekey.hex -intel -o check.bin -binary
fc /b check.bin firmware\minekey.bin
```

**方法 C：与源码对账**
```
cd firmware
build.bat
```
用 **SDCC 4.6.0**（`#16555`）编译，产物应与当前 `minekey.hex` 一致。
资源占用应为：ROM `9438 / 14336`，XRAM `271 / 896`。

---

## 七、我无法证明的部分（如实说明）

1. **无法证明芯片物理损坏的具体成因**。可观测事实是「一执行写/擦就卡死，
   断电才能恢复」，属于芯片内部 flash 操作无法完成；但这是我推断，不是测量结论。
2. **不能排除我之前的操作加速了这一过程**（例如 D+ 与 3V3 直接短接那次、
   以及反复上电循环）。这一点我不辩解。
3. **历史成功烧录用的那两个构建已不在磁盘上**（被后续编译覆盖）。
   如果你需要，我可以从当前源码重新编出对应版本，但无法还原当时那一份的字节。

---

## 八、当前源码中的关键修复（供审阅）

| 位置 | 内容 |
|---|---|
| `src/app.c:602-603` / `636-637` | `ws_send_byte` 入口 `push 0x06 / 0x07`、出口 `pop` —— 修掉 `__naked` 函数冲掉调用方 `R7` 导致的死循环 |
| `src/app.c:310` | `if (boot_ticks == 3000) enter_bootloader();` —— 长按旋钮 3 秒（1ms/tick）回 BootLoader |
| `src/app.c:66` | `enter_bootloader()` 实现（`LJMP 0x3800`） |
| `src/usb.c:509` | `USB_INT_FG = fg & (...)` —— 标志位写 1 清零 |
| `src/usb.c:185,191` | `bUEP_T_TOG` 翻转 —— EP0 手动翻转，控制读首包必须是 DATA1 |

---

## 九、2026-11-11 第二次复核 + Feature 报文修复

### 9.1 独立复核结论（与首次一致）

重新跑了 `tools\verify_hex.py`，并人工审查了校验脚本本身的逻辑：**hex 文件本身没有任何问题**。
当时的 `9438B` 版本（SHA256 `209e4aa9…`）失败点始终在「写配置位」，文件内容从未被使用。

### 9.2 芯片死因修正诊断（依据用户新提供的症状）

| 芯片 | 症状 | 修正后的诊断 |
|---|---|---|
| #1（UID 18-） | 代码 43「未知 USB 设备」 | **大概率没有死**。这正是 `usb.c` 注释记录的旧固件 EP0 缺陷症状（描述符以 DATA0 发出 → 主机丢弃 →「设备描述符请求失败」）。8766B 那次烧录**没有写配置位**（日志无该步骤），BootLoader 应该完好；「进不了 bootloader」是上电后 BootLoader 等待窗口太短、操作错过。 |
| #2（UID 1F-） | 先「读通写废」，后彻底不识别 | `autoflash.ps1` 旧版提示「短接 D+/3V3 再插 USB」——该操作把芯片内部 3.3V LDO 经主机 D+ 驱动管对地短路，叠加散新品瑕疵，电源域受损。此提示已删除。 |

另确认：**烧录工具 WCHISPStudio V4.00 对 CH552 支持存疑**（有公开案例：V3.50 不识别 CH552，WCHISPTool V2.50/V3.2 正常）。应使用本机已有的 `WCHISPTool_CH54x-55x.exe`。

### 9.3 本次代码修复

| 位置 | 修复内容 |
|---|---|
| `src/usb.c` / `usb.h` / `app.c` | **Feature 负载 64→63 字节**：`0x95 0x40`→`0x95 0x3F`、`FeatureBuf[65]`→`[64]`、GET/SET_REPORT 长度同步。63+报告ID=64=EP0 单包上限，控制传输不再跨两包，消除「最后一字节被丢弃 + 状态阶段提前 arm」的边界缺陷 |
| `tools/configurator/app.js` | `_feature()` 发送长度 63、返回按 64 剥离 reportId（桌面版/网页版同步） |
| `tools/configurator-win/HidBridge.cs` | `FeatureExchange` 按固件 caps 定缓冲长度（64），负载超限直接报错；`FeatureReportLength` 默认值 65→64、`InputReportLength` 64→9 |
| `tools/autoflash.ps1` | 删除「短接 D+/3V3」危险提示；烧录配置固定为 `GUI_nocfg.ini`（IsCodeProtect=0） |

### 9.4 新产物身份（2026-11-11 17:43 构建，全部通过 verify_hex.py）

| 文件 | 大小 | 构建变体 | SHA256 |
|---|---|---|---|
| `minekey.hex` | 9438B（0x0000–0x24DD） | **NO_LED_OUTPUT 安全版（烧录用这个）** | `785f156ca76a01235c4d3b30dd73ff4db144cb467f64fca273c11eab1a60aafc` |
| `minekey_diag.hex` | 9538B | DIAG_MARK 里程碑灯版 | 见文件属性 |
| `minekey_led.hex` | 9546B | 带 WS2812 完整功能版 | 见文件属性 |

三个变体均已按 63 字节 Feature 协议重新编译，与配置器（网页版 + 桌面版）一致。
桌面版 `bin\app\` 已重新发布（含新 HidBridge.cs）。

---

## 十、2026-11-11 17:57 真机烧录与联机验证（首次成功）

### 10.1 烧录成功（新芯片，第一次尝试即成功）

```
17:57:17:197>> 待下载BIN文件长度:9438B
17:57:17:217>> 从用户区跳转BOOT,配置位禁止修改!
17:57:17:220>> BTVER:02.50
17:57:17:223>> UID:18-3-6E-BF-0-0-0-0
17:57:17:236>> 擦除中...   擦除长度: 10K   17:57:17:561>> 完成
17:57:17:566>> 编程中...                  17:57:18:837>> 完成
17:57:18:843>> 校验中...                  17:57:19:091>> 完成
17:57:19:128>> 成功!
17:57:19:134>> <<<< 本次用时:1.922s
```

要点：

- 全程**没有「写配置位」这一行**，且明确打印「配置位禁止修改」→ 与 §4.1/§4.2 两次成功记录走的是同一条安全路径
- 这是 `9438B` 构建**第一次真正写进芯片**（此前 9438B 的每一次都死在写配置位）
- 对比 §4.4：失败时界面里「启用代码和数据保护模式」被勾上；本次该框为空

### 10.2 「校验位出错!」是工具侧误报，不是写失败

烧录后单独点「校验」按钮，报：

```
17:57:21:364>> 校验位出错! (0000c2ff:000052ff)
17:57:21:370>> 失败!
```

判断为工具侧口径问题，理由三条：

1. 下载流程**内置的「校验中…完成」已通过**——那是写后立即回读比对，权威性更高
2. 擦除长度 10K（10240B）而 BIN 只有 9438B，独立校验按整段擦除区对齐比较，尾部填充口径（0xFF / 0x00）与工具内部不一致必然报不等
3. 紧接着设备**正常枚举、配置通道正常应答**（见 10.3），程序区内容不可能有错

**结论：不要再因为这条提示重复下载。** 重复烧录才是真正的风险源。

### 10.3 联机实测（只读，未注入任何键鼠事件）

Windows PnP 枚举：

```
USB\VID_1209&PID_0001\KF00000001        Status OK
  COL01  HID Keyboard Device            （键盘）
  COL02  符合 HID 标准的用户控制设备      （多媒体）
  COL03  HID-compliant mouse            （鼠标）
  COL04  符合 HID 标准的供应商定义设备    （配置通道 0x10）
```

`tools/hidtest.ps1` 对 COL04 做一次 INFO(0x01) 往返：

```
COL04: UsagePage=0xFF00 In=9 Feat=64
SET 0x10 -> OK
GET 0x10 -> OK
   bytes: 10 81 00 01 00 0A 03 04 0B 0B 00 4B 65 79 46
```

- **Feat=64（不是 65）**：证明 63 字节负载的新报告描述符已经生效，控制传输单包完成
- 回包 `10 81 00 …` = 报告 ID 0x10 + `0x01|0x80` 回显 + 状态 0(OK) → 协议链路真机打通

### 10.4 仍然没有验证的部分（如实标注）

| 项 | 状态 |
|---|---|
| 按键矩阵实际出码 | **已验证**（用户实测可正常打字；键位已按板面丝印校正，见 §10.6） |
| SET_KEY(0x03) / SAVE(0x09) 写 DataFlash 后断电保持 | **已验证**（`tools/set_keymap.py`：SET_ALL → SAVE → RELOAD 强制从 Flash 重读，回读一致，见 §10.6） |
| LED 灯效 | 本版为 `NO_LED_OUTPUT`，**灯不亮属设计如此**；要测灯请烧 `minekey_led.hex` |

### 10.5 修正 §4.3 的一个推论

新芯片读出的 UID 同样是 `18-3-6E-BF`，与 §4.1 那颗「芯片#1」完全一致。
说明 **UID 前几字节是批次/晶圆信息，不能用来区分个体芯片**，§4.3 用「18 ≠ 1F」判定两颗芯片的推论不成立（结论本身——确实是两颗——仍由物理事实支持）。

### 10.6 2026-11-11 18:2x 键位校正 / 写入通路 / 主机动作

**① 键位校正（出厂表 + 设备实际值都已改）**

固件 `DEF_KEYS[]` 按板面丝印重写，出厂键位变为：

| 排 | 第 1 列 | 第 2 列 | 第 3 列 | 第 4 列 |
|---|---|---|---|---|
| 上排 | CN9 = A `0x0104` | CN10 = B `0x0105` | CN11 = Win+R `0x5815` | 旋钮 |
| 中排 | CN5 = 1 `0x011E` | CN6 = 2 `0x011F` | CN7 = 3 `0x0120` | CN8 = 4 `0x0121` |
| 下排 | CN1 = 光标↑ `0x0701` | CN2 = 6 `0x0123` | CN3 = 7 `0x0124` | CN4 = 8 `0x0125` |

`0x5815` 与配置器用户手动写入 Win+R 时产生的值完全一致，编码正确性有交叉验证。

**② 写入通路与 DataFlash 保持性已验证（新增 `tools/set_keymap.py`）**

```
[i] 已连接：协议 v1 固件 0.10  矩阵 3x4 键位 11 灯珠 11
[i] 11 个键位已下发
[i] 回读（已经从 DataFlash 重新加载）: K1 0x0701 … K11 0x5815
[✓] 完成
```

链路：`SET_ALL(0x04)` → `SAVE(0x09)` → `RELOAD(0x21)`（强制 `cfg_load()` 从 DataFlash 重读）
→ `GET_KEYMAP(0x02)`。**回读与写入一致 = 配置真的落盘了**，这是第一次验证存储通路。
因此键位**不需要重烧固件**就能改：`python tools/set_keymap.py`。

**③ 主机动作"没反应"的根因**

| 可能原因 | 实测结论 |
|---|---|
| 报告描述符没声明 ID 5 | 已声明（ID 序列 1/2/3/4/5/0x10），排除 |
| 固件没发 | `app_tick()` 里 `usb_ep1_send([5, action])` 正常 |
| 电脑端代理没跑 | **命中**：`hid` 模块缺失（hidapi 未装）+ 代理进程不存在 |

修复：`pip install hidapi`（已装到 `D:/Python`）+ 新增 `tools/host-agent/start_agent.bat` 一键启动。
读通路实测正常：打开 usage_page=0xFF00 集合成功，`read(500ms)` 收到状态报文 `[3,0,0,0,0,0,0,0,0]`，
证明输入报文确实是"首字节 = 报告 ID"的格式，代理 `data[0] == 5` 的判断成立。

**④ 本轮新产物**

| 文件 | 地址范围 | SHA256 |
|---|---|---|
| `minekey.hex`（NO_LED，烧录用） | 0x0000–0x24DD | `714e5ae7a6efec27…` |
| `minekey_diag.hex` | 0x0000–0x2562 | `0e50df03d9d63f5d…` |
| `minekey_led.hex`（带灯，测灯用） | 0x0000–0x2549 | `57c1f1ef34fcfe4f…` |

三个变体均通过 `verify_hex.py`，均未越过 0x37FF。

### 10.7 2026-11-11 18:30 根因定性：错的是**接线映射**，不是键表

**现象**：用户按物理丝印 CN1 的键，出的是 `4`；而驱动界面上 CN1 显示的是「光标↑」。

**推理（一步就定死了）**：

1. 当时的键表把 `4` 放在 key7（`0x0121`）
2. 物理 CN1 出 `4` ⇒ 物理 CN1 落在 **bit8 = (R3,C1)**
3. 说明 ROW1 是**上排**、ROW3 是**下排**，COL1..COL4 左→右

于是真实接线是：

| bit | 电气 | 物理 | 键索引 |
|---|---|---|---|
| 0..2 | R1C1..R1C3 | 上排 CN9 CN10 CN11 | 8 9 10 |
| 3 | R1C4 | 旋钮按压 | — |
| 4..7 | R2C1..R2C4 | 中排 CN5..CN8 | 4 5 6 7 |
| 8..11 | R3C1..R3C4 | 下排 CN1..CN4 | 0 1 2 3 |

**原来的错**：`bit_to_key` 写成了蛇形填充 `{0,1,2,-1,3,4,...}`，相当于假设"CN1 在 R1C1"
（即下排接 ROW1），把上下两排整个倒过来了。而 CN4 之后又继续按 R2C1 续排，导致
上下两排还各错一位。**键表从来没错，错的是 bit→键 的排列。**

**修正**：

| 位置 | 改动 |
|---|---|
| `firmware/src/app.c` | `bit_to_key` → `{8,9,10,-1,4,5,6,7,0,1,2,3}`（键索引 = CN 编号 − 1） |
| `firmware/src/board.h` | 新增 `CFG_VERSION 2`；`cfg_load()` 版本不符即回出厂值 → 烧新固件后**旧配置自动作废**，不用手动恢复出厂 |
| `tools/configurator/app.js` | `LAYOUT` 的 row/col 与 `MATRIX_TO_KEY` 同步修正（"测试"高亮才对得上） |
| `tools/set_keymap.py` | 新增 `--old-fw`：给未烧新固件的场合写"补偿表"，立刻能正常打字（但界面标签仍对不上，属临时手段） |

**新产物**（全部通过 `verify_hex.py`，均未越过 0x37FF）：

| 文件 | SHA256 |
|---|---|
| `minekey.hex`（NO_LED） | `23d4a16ed3f87b16…` |
| `minekey_diag.hex` | `2867996ee44081e9…` |
| `minekey_led.hex`（带灯） | `74c6bbd4493ba7a8…` |

**结论**：烧这一版之后，"界面 CN 标签 = 板面丝印 = 实际按键"三者一致，
且 DataFlash 里的旧配置会因为版本号变化自动重置为正确出厂表。

### 10.8 2026-11-11 19:4x 灯效三项修复（灯位 / 亮度 / 速度）

**① 灯位不对：灯珠是蛇形串联，和键位顺序无关**

按 `keyboard.epru` 里元件的 PCB 坐标反推（灯珠行与键位行恒定偏移 210mil，同排同列配对）：

| 链条序号 | 0 | 1 | 2 | 3 | 4 | 5 | 6 | 7 | 8 | 9 | 10 |
|---|---|---|---|---|---|---|---|---|---|---|---|
| 灯珠 | U5 | U4 | U3 | U2 | U9 | U8 | U7 | U6 | U12 | U11 | U10 |
| 键 | CN3 | CN2 | CN1 | CN4 | CN5 | CN6 | CN7 | CN11 | CN10 | CN9 | CN8 |

链条走线：`R1 → U5 → U4 → U3 → U2 → U9 → U8 → U7 → U6 → U12 → U11 → U10`，相邻间距均匀约 785mil，
且起点 U5 离主控最近（880mil，另一端 U10 为 2156mil），可判定方向。
原配置器 `LED_ORDER` 是恒等表（假设"第 n 颗灯就是第 n 个键"），所以颜色整排错位。

修复：`app.js` 的 `LED_ORDER` → `[2,1,0,3,4,5,6,10,9,8,7]`，界面上「灯珠」改显示真实位号（U3 等）。
`per_key[]` 仍按链条序号存储，固件只在「按压缩放」模式需要 `LED_KEY/LED_KEYBIT` 反查键与矩阵位。

**② 亮度：满档改 70%，呼吸加深**

| 项 | 原 | 现 |
|---|---|---|
| 满亮度 | `led_bright` 直接当 0..100% | `#define LED_FULL 70`，100 档 = 原来的 70% |
| 呼吸深度 | 100%～60%（只有 40% 摆幅，肉眼几乎看不出） | 100%～10% |

**③ 速度滑杆失效：`led_speed` 只存不用**

`cfg.led_speed` 只在 `CMD_GET_LED/CMD_SET_LED` 里读写，`led_effect()` 里**一次都没引用** —— 滑杆必然是死的。
修复：`app_tick()` 的 20ms 节拍改成累加器推进 `led_t`，速率 `25 + speed*7/4`（每拍 0.25～2 个 tick，约 4 倍速差）。

**④ 顺带修：`start_agent.bat` 编码**

原文件是 UTF-8 中文 + `chcp 65001`，cmd 在切换代码页后按字节偏移续读会错位，
把 `rem` 注释行当成命令执行（`'閫€鍥?PATH' 不是内部或外部命令`）。
改为**纯 ASCII**（0 个非 ASCII 字节），不再依赖代码页。

**新产物**：`minekey.hex` `c8cac8816efd3471…`（0x0000–0x2532）、
`minekey_diag.hex` `5416e67e336d540c…`、`minekey_led.hex` `d1a7d72551b3cb3f…`，均通过校验。

### 10.9 2026-11-11 20:0x 灯序以实物为准 + 主机动作连发 bug

**① 灯序更正（覆盖 §10.8 的坐标反推结果）**

用户实测实物灯链为：

```
CN11 → CN10 → CN9 → CN5 → CN6 → CN7 → CN8 → CN4 → CN3 → CN2 → CN1
```

§10.8 里按 PCB 坐标 + "旋钮在 R1C4"推出来的顺序（U5→U4→…→U10）**与实物不符，作废**。
推论：坐标反推依赖"编码器接 bit3"这个前提，而该前提与实物灯链互相矛盾，
说明 `ENC_BIT` 或行序假设至少有一处不成立 —— 但**键位已实测正确、灯链以实物为准**，不再依赖几何推断。

按"键索引 = CN−1"换算：

| 链条序号 | 0 | 1 | 2 | 3 | 4 | 5 | 6 | 7 | 8 | 9 | 10 |
|---|---|---|---|---|---|---|---|---|---|---|---|
| 灯珠(位号) | U6 | U12 | U11 | U9 | U8 | U7 | U10 | U2 | U5 | U4 | U3 |
| CN | 11 | 10 | 9 | 5 | 6 | 7 | 8 | 4 | 3 | 2 | 1 |
| 键索引 | 10 | 9 | 8 | 4 | 5 | 6 | 7 | 3 | 2 | 1 | 0 |

固件 `LED_KEY = {10,9,8,4,5,6,7,3,2,1,0}`、`LED_KEYBIT = {2,1,0,4,5,6,7,11,10,9,8}`，
配置器 `LED_ORDER = [10,9,8,7,3,4,5,6,2,1,0]`（互为逆）。

**② 严重 bug：主机动作按住会连发**

代理一启动就刷屏 `[>] 下载文件夹`（3 秒内 9 次）。根因在 `keys_update()`：

```c
if (active_sw[k] == 0) {
    if (T_ACTION) run_action(...);            /* 没占住 active_sw */
    else if (T_HOST) host_action_pending=…;   /* 没占住 active_sw */
    else if (code) active_sw[k] = code;
}
```

`T_ACTION` / `T_HOST` 分支不写 `active_sw[k]`，于是"按下沿"判定永远成立：
**按住不放 = 每 1ms 触发一次**（1 秒上千次）。这既让主机动作看起来"乱发"，
也让"亮度±"类动作一按到底。

修复：两个分支都写 `active_sw[k] = code;`，靠松手清零恢复边沿检测。
`apply_code()` 对这两种类型本来就不产生 HID 报文，所以不会误发键码。

**③ 代理改为非阻塞轮询**

`agent.py` 由阻塞 `read(64,1000)` 改为 `set_nonblocking(1)` + `read(64,0)` + 10ms 轮询。
原因：配置器/其它工具同时打开同一个 HID 集合时，阻塞 ReadFile 会被抢占，
表现为刷屏的 `[!] 读失败，重连：read error`（后台跑 1.5 小时全程如此）。

**新产物**：`minekey.hex` `3d0568ee72601e43…`（0x0000–0x2554）、
`minekey_diag.hex` `90349725518bdc47…`、`minekey_led.hex` `9497f0c9b32e55d5…`。

### 10.10 2026-11-11 20:1x 主机动作：开软件 / 开网页失败

**根因：试跑和按键走的是两条不同的执行路径。**

| 触发方式 | 谁执行 | 实际用的 API |
|---|---|---|
| 配置器「试跑」 | 桌面版 C# `Program.cs` | `Process.Start(UseShellExecute=true)` → ShellExecute |
| 按键 | `tools/host-agent/agent.py` | `subprocess.Popen` / `webbrowser.open` |

于是同一个目标两边表现不同：

- **开软件**：目标 `D:/Microsoft VS Code\Code.exe` **带空格**，旧代码 `target.split(" ", 1)`
  劈成 `"D:/Microsoft"` + `"VS Code/Code.exe"`，前者不存在 → 必定失败
- **开网页**：`webbrowser.open()` 依赖 BROWSER 环境与默认浏览器注册，比 ShellExecute 脆弱
- **文件夹 / 锁屏**：`os.startfile` / `shell=True` 恰好可用，所以"这两个没问题"

修复（`agent.py`）：

1. 三种类型统一走 `ShellExecuteW`，和试跑同一条系统路径；返回值按 `HINSTANCE` 处理
   （默认 `c_int` 在 64 位会被截断），≤32 视为失败并给出错误码含义
2. 新增 `_split_target()`：带引号按引号拆；否则先判断整串是否真实存在的文件
   （解决路径含空格），最后才退化到按空格拆
3. url 缺协议时自动补 `https://`（与配置器试跑规则一致）
4. 启动时打印全部槽位（编号 → 名称 / 类型 / 目标），便于核对"键发的编号"与"代理里的槽位"是否一致

**另一个坑：动作表有两份，互不同步。**

配置器的槽位表存在 WebView2 的 localStorage（键 `kf.actions.v3`），`actions.json` 是另一份，
只有点「导出 actions.json」才会同步。实测读到用户桌面版的表：

| 槽位 | 配置器里 | actions.json |
|---|---|---|
| 0 | 打开 B 站 (url，已填) | 同 |
| 1 | VS Code (app，已填) | 同 |
| 2 | 下载文件夹（**target 空**） | 已填 Downloads |
| 3 | 锁屏（**target 空**） | 已填锁屏命令 |

⇒ 用户看到的"文件夹 / 锁屏能用"其实是**代理**在跑（用 actions.json），
而「试跑」对这两个槽位会报"先填目标"。**若此时直接导出，会把 json 里那两项冲成空。**

另：配置器开着时代理也开着，一次按键会被两边各执行一次
（`dev.onReport` 的 `id===5` 分支也在本地跑），建议只留一个。

### 10.11 2026-11-11 20:2x 动作表自动同步（取消手动导出）

**问题**：配置器的槽位表存在 `localStorage`，代理读 `actions.json`，两份不同步。
改完槽位忘记导出，就会出现"界面上是 QQ、按下去开 Projects"这种错位
（实测：CN2 发 `0x06**04**` → 槽位 4 → 旧 json 里是 Projects）。

**改法（三层）**：

| 位置 | 改动 |
|---|---|
| `tools/configurator-win/Program.cs` | 新增桥命令 `writeActions`：从 exe 目录逐级向上找含 `host-agent` 的目录，直接写 `actions.json`（不用弹保存框） |
| `tools/configurator/app.js` | `saveActions()` 里加 400ms 去抖的自动同步；导出按钮与自动同步共用 `actionsPayload()`。槽位下拉框编号由 `i+1` 改为 `[i]`，与 json 键、代理日志、原始码 `0x06xx` 统一 |
| `tools/host-agent/agent.py` | 每秒检查 `actions.json` 的 mtime，变了就重载 —— 改完连代理都不用重启 |

**实测**：改文件后代理 1 秒内打印 `[↻] actions.json 变了，已重新载入 5 个动作`；
`MineKey.dll` 内已含 `writeActions` 字串（构建于 20:24）。

**限制**：网页版（浏览器打开）没有本地写文件权限，仍只能手动「导出 actions.json」。
桌面版 `bin\app\MineKey.exe` 才具备自动同步能力。

### 10.12 2026-11-11 20:3x 槽位 0 永远发不出去（网页动作失效的真凶）

**现象**：主机动作里"文件夹 / 锁屏 / QQ / VS Code"都能用，唯独"开网页"（槽位 0）没反应。

**根因**：`app_tick()` 里用变量本身当"有没有待发动作"的标志：

```c
static __xdata uint8_t host_action_pending;      /* 零初始化 = 0 */
...
if (host_action_pending) {                       /* ← 0 号动作到这里就为假 */
    hb[1] = host_action_pending;
    if (usb_ep1_send(hb, 2)) host_action_pending = 0;
}
```

动作编号 **0 是合法槽位**（配置器第一个），但 0 同时被当成"空"，
所以 `0x0600` 按下后 `host_action_pending = 0`，`if` 直接不成立 —— 报文永远不发。
其余槽位（1/2/3/4）编号非零，所以都正常。这就是"只有网页不行"的全部原因。

**修复**：改用 `0xFF` 作空值。

```c
#define HOST_ACTION_NONE 0xFF
static __xdata uint8_t host_action_pending = HOST_ACTION_NONE;
...
if (host_action_pending != HOST_ACTION_NONE) { ... host_action_pending = HOST_ACTION_NONE; }
```

（槽位 0xFF 实际上不可达：配置器只有 12 个槽位。）

**已排除**：系统侧 ShellExecute 打开 `https://www.bilibili.com` 实测正常
（默认浏览器 Chrome，`ChromeHTML` 关联完整），所以不是浏览器/关联问题。

**新产物**：`minekey.hex` `7651807214585bcd…`（0x2558）、
`minekey_diag.hex` `520543f92ca8a817…`、`minekey_led.hex` `53156e583f26e5ed…`。

### 10.13 2026-11-11 20:5x 旋钮按下无法写入 + 新出厂键位

**① 旋钮按下"写不进去"：写入没有落盘**

`writeEnc()` 只发 `CMD_SET_ENC`，**从不发 `CMD_SAVE`**。结果：RAM 里改好了，
界面也显示新值，一拔电又回旧值；下次连上重新 `GET_ENC` 就是老的 —— 表现为"根本改不了"。

用直连协议复现并验证：

```
当前  PUSH=0x02CD
SET_ENC 0x02E2 → 状态 0
回读  PUSH=0x02E2          ← RAM 生效
SAVE + RELOAD → PUSH=0x02E2 ← 落盘也正常
```

说明协议和固件都没问题，**纯粹是前端少调了一次 SAVE**。

修复（`app.js`）：

1. `写入旋钮` 按钮：`writeEnc()` 之后补 `dev.save()`
2. 按键页对"旋钮"用写入时（`writeCurrent`）同样补 `dev.save()`
3. 未连接时直接拒绝并提示（原来是静默写进本地对象，看着像成功）
4. 三个下拉框加 `change` 监听同步进 `S.enc` —— 否则任何一次 `renderSidebar` 重绘
   都会按 `S.enc` 重建 `<select>`，把刚选的值冲掉
5. 日志里补上「按下=…」，改没改一眼能看出来

**② 新出厂键位（只影响新芯片 / 恢复出厂）**

| 排 | 第 1 列 | 第 2 列 | 第 3 列 | 第 4 列 |
|---|---|---|---|---|
| 上排 | CN9 = 9 | CN10 = 0 | CN11 = Backspace | 旋钮 |
| 中排 | CN5 = 5 | CN6 = 6 | CN7 = 7 | CN8 = 8 |
| 下排 | CN1 = 1 | CN2 = 2 | CN3 = 3 | CN4 = 4 |

`DEF_ENC = { 音量+ 0x02E9, 音量- 0x02EA, **按下 0x02E2(静音)** }`

没有改 `CFG_VERSION`：新芯片 DataFlash 是空的（magic 校验不过）→ 上电自动套用新默认；
现有芯片的个性化配置不会被冲掉。

**③ 长按 3 秒进 BootLoader 未受影响**

那段在 `boot_hold_poll()`：直接拉低 COL4 读 ROW1，绕开矩阵状态机与 `cfg.enc[2]`，
和旋钮动作配置完全无关。本次只改了 `DEF_ENC` 的第三个元素。

**新产物**：`minekey.hex` `f725e190553a21d3…`（0x2558）、
`minekey_diag.hex` `79b79953b7d9837d…`、`minekey_led.hex` `7d2bc5cb0fe8fa0b…`。

### 10.14 2026-11-11 21:0x 键位落位 / 动作精简 / 鼠标光标合并

**① 为什么"默认键位没改"**

`DEF_KEYS` 在固件里，只在**出厂表被采用时**才生效：新芯片（DataFlash 空，magic 校验不过）
或 `恢复出厂`。§10.13 特意**没有**改 `CFG_VERSION`，就是为了不冲掉现有芯片的自定义配置——
于是这颗芯片数据区里仍是旧表（CN1 = `0x0701` 光标↑），看起来像"改了没生效"。

处理：直接用 `tools/set_keymap.py` 把新表写进设备并落盘（回读确认）：

```
K1 CN1 0x011E ... K9 CN9 0x0126, K10 CN10 0x0127, K11 CN11 0x012A(Backspace)
```

⚠️ 副作用：原来绑在 CN2/CN5/CN9 的主机动作被覆盖，需要时在配置器里重绑。

**② 内部动作 → 灯效设置（删掉危险动作）**

`重新加载配置(5)` / `恢复出厂设置(6)` 从**界面和固件两边**一并删除：

| 位置 | 改动 |
|---|---|
| `app.js` `ACTIONS` | 只剩 `亮度+ / 亮度− / 下一个灯效`，分组名改「灯效设置」 |
| `index.html` | 类型下拉把「内部动作」改为「灯效设置」 |
| `app.c` `run_action()` | 删掉 `ACT_RELOAD` / `ACT_RESET` 分支 |
| `board.h` | 删掉 `ACT_RELOAD` / `ACT_RESET` 宏 |

理由：这两个动作只能由配置器经 Feature 通道发起。一旦绑到按键上，误按一下
就把 11 个键全清回出厂值，是不可接受的失效方式。

**③ 鼠标 + 光标合并**

新增界面伪类型 `T_POINTER = 8`：

- 类型下拉里 `鼠标` 与 `光标移动` 合并为一项「鼠标与光标」
- 值列表把 `0x03xx`（左/右/中键、滚轮上/下）与 `0x07xx`（光标上下左右）混排
- `renderSidebar` 把 codeType 3/7 都映射到 8，并把**完整功能码**传给值选择器
- `btnAssign` 对 8 号类型直接取完整码，不再做 `(t<<8)|v` 拼接
- 旋钮的 `buildCodeOptions` 同步合并成一组

**功能码本身没有变化**（`0x03xx` / `0x07xx` 各按各的），所以老配置、老固件照样认。

**新产物**：`minekey.hex` `abaefe4d97a936d5…`（0x2545）、
`minekey_diag.hex` `15372eec5e74d9bd…`、`minekey_led.hex` `6264ea9594fa2f68…`。

### 10.15 2026-11-11 21:1x 出厂灯效

`cfg_defaults()`：`led_mode=1`（呼吸）、`led_bright=30`、`led_speed=50`、
`led_rgb = #F77634`、`per_key[0..10]` 全部 `#F77634`。

同样只影响新芯片 / 恢复出厂，所以另外用新增的 `tools/set_led.py` 把这份配置
直接写进当前芯片并落盘（`SET_LED` → `SAVE` → `RELOAD` 回读校验）：

```
模式=1 亮度=30% 速度=50 主色=#F77634
11 颗灯珠颜色：全部 = 主色
```

注意：亮度 30% 还要经过 `LED_FULL=70` 的满量程限制，实际输出约为满亮的 **21%**。
嫌暗就用 `python tools/set_led.py --bright 50`（约 35%）。

新产物：`minekey.hex` `aee16a8f3dc727c4…`、`minekey_diag.hex` `4907e7cad97951b2…`、
`minekey_led.hex` `4ad0f8c8581889be…`。

### 10.16 2026-11-11 21:1x 全新芯片烧不进去 → 改用命令行烧录器

**现象**（WCHISPStudio V4.00，第 4 颗全新芯片，UID `1D-3-6E-BF`）：

```
21:13:49 待下载BIN文件长度:9650B
21:13:49 [Dev0]开始下载... BTVER:02.50  UID:1D-3-6E-BF
21:13:49 配置位校验失败!
21:13:49 失败!
```

**关键点：失败发生在「写配置位」这一步，日志里「擦除中 / 编程中」一行都没有 —— 代码区一个字没被碰，芯片完好。**
之后仍能枚举为 `USB\VID_4348&PID_55E0`（BootLoader），说明只是进不去烧录流程。

17:57 那次成功（芯片 #3）日志里多一行 **`从用户区跳转BOOT,配置位禁止修改!`** ——
即工具当时**跳过**了配置位处理；这次没跳过，所以死在第一步。
（为什么状态会变，还没有定论；工具的把配置位状态存在
`WCHISPTool_CH54x-55x\CONFIG_CH54X55X.WCH`，mtime 20:39，可疑但未改动。）

**解决办法：走 `ispprog.exe` 命令行烧录器**（`…\WCHISPTool_CH54x-55x\ispprog\ispprog.exe`）

它内部调 `SetIspOption(1, mode=noprotect)`，**整体跳过配置位/保护位**，只做擦除+编程+校验：

```
[1] SetIspOption -> 1 (mode=noprotect)
[2] EnumDevices -> 1 台  dev0: index=0 mcu=0x00 (cold)
[3] 载入 minekey_led.hex  27264 字节（HEX 文本）
[4] FlashProgramB -> 1          ← 编程成功
[5] FlashVerifyB  -> 0          ← 该小工具未把校验结果计入结论，需实测确认
结果：成功
```

**注意**：必须先把 WCHISPStudio / WCHISPTool 全部关掉——它们会独占 HID 设备，
命令行工具能枚举到但 `FlashProgramB` 返回 0（打不开句柄）。这是第一次失败的真实原因。

烧完工具**不发"运行"命令**，芯片仍停在 BootLoader，需拔插一次 USB 才会运行用户程序。

新增 `tools/flash_cli.bat`（纯 ASCII，双击即烧，可传 hex 路径参数），作为日常烧录入口。
