BigFishC68/MineKey/hardware/Keyboard_sch.pdf

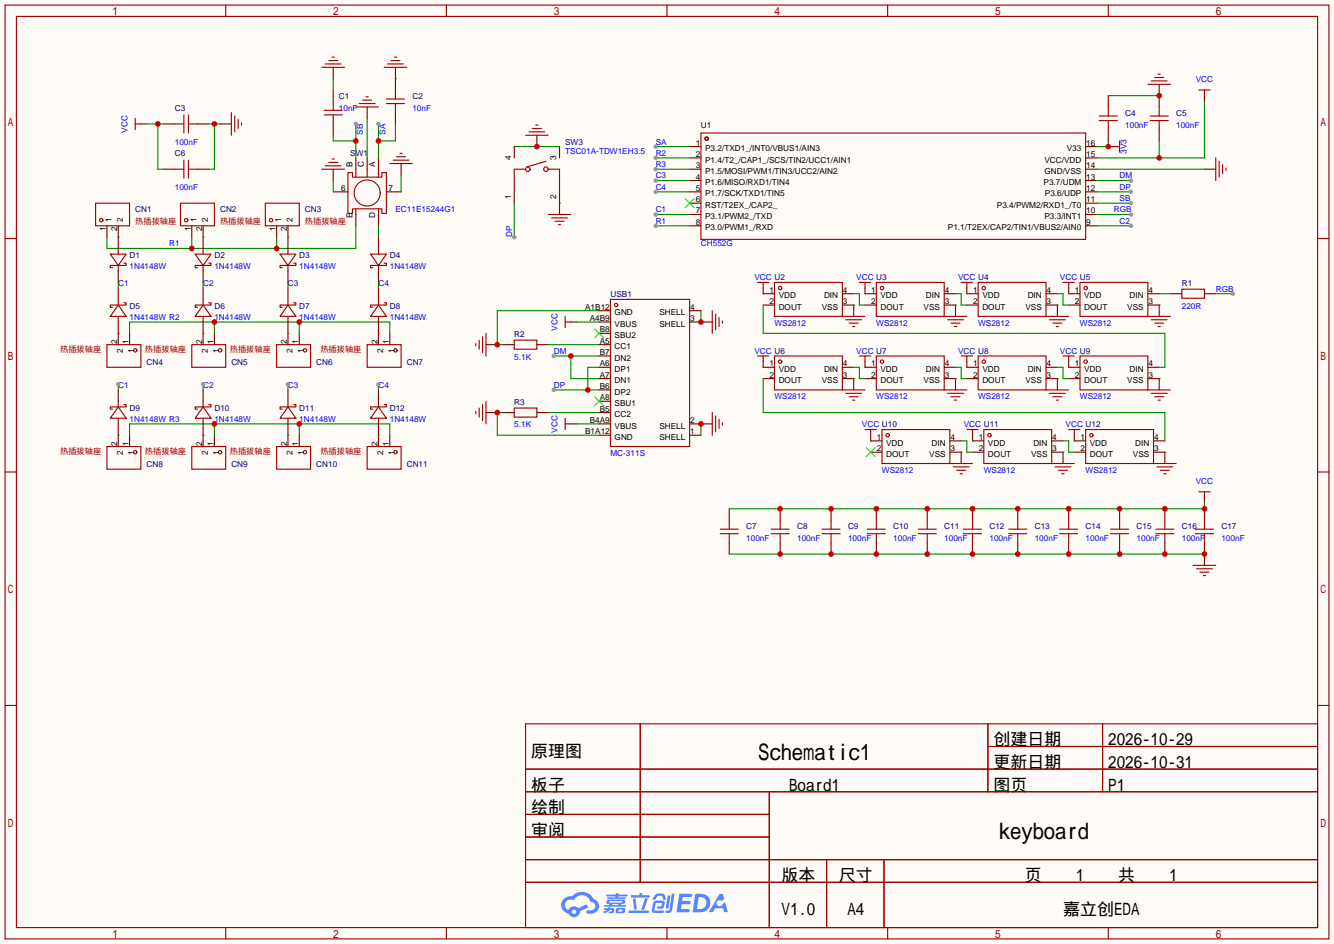
[picture p4: page 1]

P3.3/INT1 10 P3.4/PWM2/RXD1_/T0 11 P3.6/UDP 12 P3.7/UDM 13 GND/VSS 14 VCC/VDD 15 V33 16

GND B1A12 VBUS B4A9 CC2 B5 SBU1 A8 DP2 B6 DN1 A7 DP1 A6 DN2 B7 CC1 A5 SBU2 B8 VBUS A4B9 GND A1B12

原理图 | Schematic1 | 创建日期 | 2026-10-29

更新日期 | 2026-10-31

板子 | Board1 | 图页 | P1
绘制 | | keyboard
审阅

V1.0 | A4 | 嘉立创EDA
