BigFishC68/MineKey/(commit log)

2026-11-11 MineKey：CH552 十一键 + EC11 旋钮键盘
    - firmware/ CH552 固件（SDCC / 8051）：矩阵扫描、灯效、DataFlash 配置、HID Feature 协议
    - tools/ 配置器（网页 + C# 桌面壳）、主机动作代理、命令行烧录器与调试脚本
    - docs/ 原理图审查、协议、使用说明、固件校验与调试记录
    - hardware/ 原理图 / EDA 工程 / 板图 / 官方手册
2026-11-11 README 补充配置器界面截图
2026-11-12 修复断电丢配置 + 主机动作开机自启 + 动作表改为本地
    - 配置器：writeKey/writeLed/writeEnc 写完自动存盘（700ms 去抖），
    原来只有旋钮和「保存」按钮会 SAVE，改键位/改灯拔电就回默认
    - 主机动作：新增 install/uninstall_autostart.bat（pythonw 后台 + 启动项），
    agent.py 增加 --log 文件日志、命名互斥体防双开
    - 仓库卫生：actions.json 移出版本控制，改由 actions.example.json 模板
    首次运行自动复制；公开仓库不再包含个人路径
2026-11-12 键码表去重 + 光标三档速度与连击提速
    - 键码表：移除 Num 0-9 / Num Enter / Num .（与主键盘重复）
    和右侧修饰键 0xE4-0xE7，左右各一套只留左边；88 项无重复
    - 光标移动：档位编进低字节高 4 位 (X<<4)|方向，6/12/24 px 每 20ms；
    MOVE_STEP 3→6（原来 150px/s 太慢），老码 0x0701 归档位 0
    - 连击提速：快速双击 ×2、三击 ×3，松手 400ms 清零
    - 配置器：值列表里找不到当前码时补一条兜底项，避免静默回落成 'A'
    - 文档：README 协议段、docs/03 出厂键位与光标章节同步
2026-11-12 修复 flash_cli.bat 默认固件路径
    整理目录时 hex 挪到了 firmware/release/，脚本里还写着旧路径。
    改成相对脚本位置解析（仓库可移动），并支持只写文件名：
    flash_cli.bat -> firmware/release/minekey_led.hex
    flash_cli.bat minekey.hex -> 同上目录里按名字找
2026-11-12 光标灵敏度滑杆 + 滚轮长按连发
    固件：
    - 移动档位改为 16 档线性（6+档位×2 px 每 20ms，300-1800 px/s），
    取代原来的 3 档移位；老码 0x0701 仍是档位 0
    - 新增 mouse_wheel_tick()：滚轮按住 300ms 后每 60ms 重复一格，
    原来只在按下沿发一次，长按无反应
    配置器：
    - 选中光标键时出现「灵敏度」滑杆（16 档，显示 px/20ms 与 px/s），
    松手才写入，避免拖动时反复存盘
    - 移动键的值列表恢复成 4 个方向，速度改由滑杆控制；
    换方向时自动保留原档位
    - 光标码在值下拉里按 0xFF0F 掩码匹配，避免高档位码被判为已弃用
    文档：README 协议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
2026-11-12 连击窗口可调 + 斜向同时按不再误判双击 + 修前端缓存
    - 连击窗口改为可调（2..50 拍 = 40..1000ms），存在 DataFlash 95 号字节，
    在 keyboard_config_t 之外，不动结构体、老配置不失效
    - 新增 CMD_GET_MOVE(0x0C) / CMD_SET_MOVE(0x0D)
    - 修：上+右一起按会被当成双击加速。现在只有手上没按住别的方向键
    才算一次点击，斜着走不再触发连击
    - 光标键面板增加「连击窗口」滑杆（100-800ms，全局）
    - index.html 给 css/js 加 ?v= 版本号，避免 WebView2 缓存导致改了看不到
    （之前 bin\Release 的 www 是旧副本，滑杆因此没出现）
    文档：docs/03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
2026-11-12 光标灵敏度最低档 6px → 3px
    档位范围变成 3..33 px 每 20ms（150..1650 px/s），16 档不变，
    滑杆最左端可以调到更精细的慢速。固件 MOVE_STEP 3、前端 MOVE_PX_MIN 3 同步，
    index.html 缓存版本号升到 b，文档里的对照表一并更正。
2026-11-13 鼠标键可长按 + 新增侧键（前进/后退）
    - 修：移动/滚轮报文里 buttons 写死成 0，发一包就把按住的鼠标键松开了，
    表现为'按住左键拖不动'。新增 mouse_buttons() 聚合当前按键状态并带上
    - 报告描述符：鼠标按钮 3 个 → 5 个（0x29,0x03→0x05, 0x95,0x03→0x05,
    补齐位 0x75,0x05→0x03），字节数不变仍是 172，CfgDesc 无需改
    - apply_code 支持 v=6 后退(Btn4,bit3) / v=7 前进(Btn5,bit4)
    配置器：鼠标选项增加「侧键 · 后退 / 前进」，左右中键标注可按住
    文档：docs/03 鼠标章节重写（按下/松开语义、滚轮连发、侧键映射）
    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
2026-11-13 界面精简 + 换新图标
    - 删掉五处冗长提示（光标灵敏度、连击窗口、组合键、主机动作、协议路径），
    鼠标选项去掉「（可按住）」这类废话
    - 左上角标志从 CSS 色块改成内联 SVG：3 行 4 列键位 + 右上旋钮，与实物一致
    - 图标重做：深色圆角底板 + 11 个绿色键位 + 青色旋钮，与界面标志同一套坐标
    （assets/icon.png 供预览，tools/configurator-win/assets/icon.ico 多尺寸）
    - 移除不再使用的 ico.jpg / ico.psd
    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
2026-11-13 沿用原图标：左上角改用 assets/ico.jpg，恢复被误删的 ico 资源
    上一版我自作主张重画了图标，是错的：
    - 恢复 assets/ico.jpg、assets/ico.psd、tools/configurator-win/assets/icon.ico（原文件）
    - 界面左上角直接显示原图标（tools/configurator/logo.jpg），不再用重画的 SVG
    - 移除我生成的 assets/icon.png
    界面提示文字的删除保持不变。
